AndrewBCN/STM32-GPSDO/docs/pictures/CTI_datasheet1.jpg

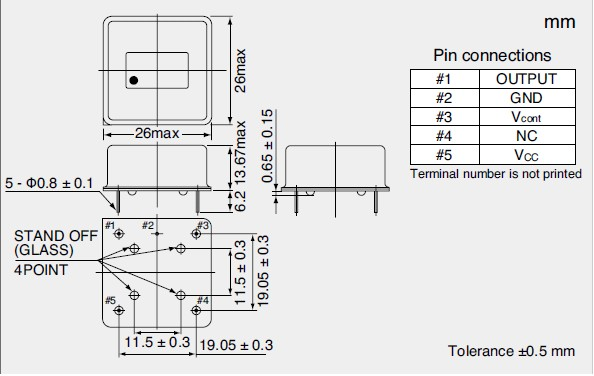
docs/pictures/CTI_datasheet1.jpg
