AndrewBCN/STM32-GPSDO/docs/pictures/CTI_OCXO_bottom.jpg

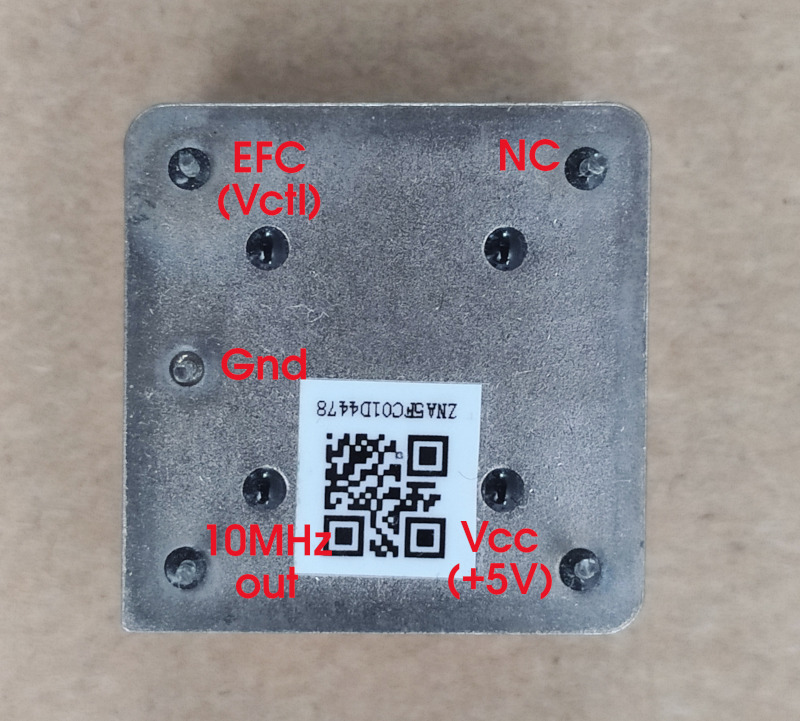
docs/pictures/CTI_OCXO_bottom.jpg
