AndrewBCN/STM32-GPSDO/docs/pictures/CTI_OCXO_top.jpg

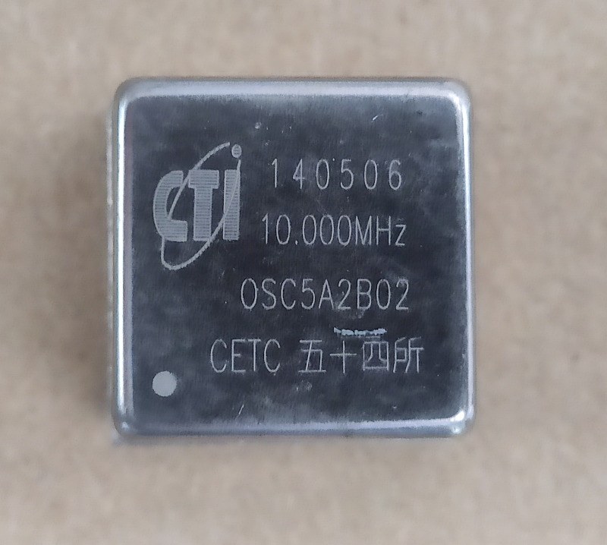
docs/pictures/CTI_OCXO_top.jpg
