AndrewBCN/STM32-GPSDO/docs/pictures/ocxo_datasheet2.png

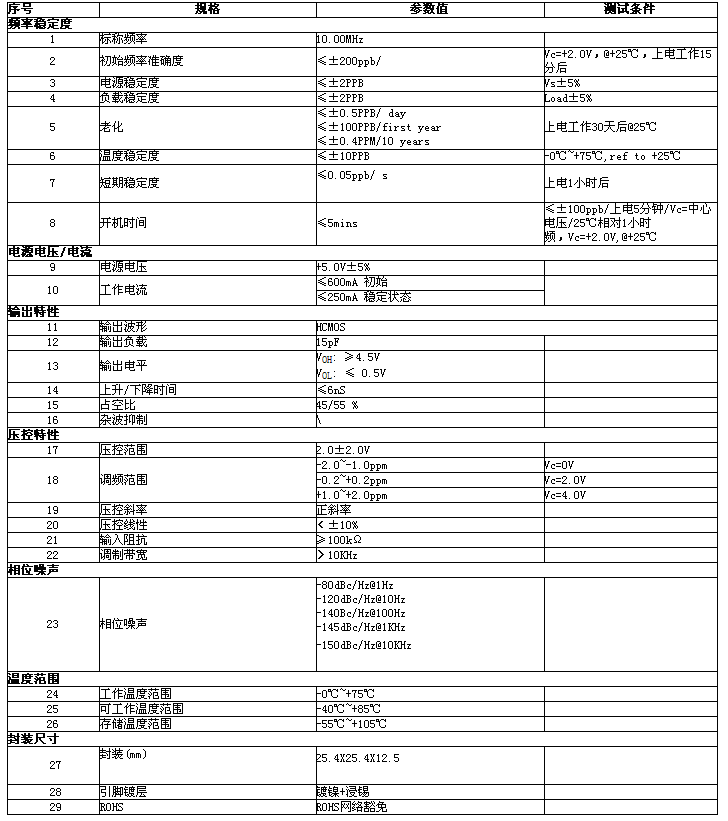
docs/pictures/ocxo_datasheet2.png
