AndrewBCN/STM32-GPSDO/(threads)

Thread 3 (2022-01-03):

STM32_CORE_VERSION error

dungar43, 2022-01-03:
I am new to this. After researching the error below I do'nt know what to do about it.
#error "Due to API change, this sketch is compatible with STM32_CORE_VERSION  >= 0x02000000"
I am compiling your code on the Arduino IDE 1.8.19 on a clone Blackpill. Libraries all work except for this error.

AndrewBCN, 2022-01-04:
This error during compilation means **you should update** the STM32 Arduino Core to a version 2.0.0 or later. The latest version is 2.2.0 and you can find it here: https://github.com/stm32duino/Arduino_Core_STM32.
This is very easy to do and takes just a couple of minutes. You are probably using one of the older versions (1.9.0 or earlier) which have bugs that prevent proper compilation of the STM32 GPSDO code.

dungar43, 2022-01-27:
Thanks for the prompt reply. I'm getting back to this now and I can compile
and load the code on to the F411 but I can't get past the GPS
initialization.  Looks like you use Serial1
for GPS communication but I can't see what IO pins are assigned to Serial1.
I'm loading the code using a UART on pins A9,10.  I find how to use serial
ports on the  STM32 series to be confusing. Any ideas will be  appreciated.

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

felixd, 2022-01-28:
Hi, If I can jump into this thread.

@dungar43 **A9 and A10** pins are used for UART communication with GPS.

You can find Andrews **Schematics** here
https://www.eevblog.com/forum/projects/yet-another-diy-gpsdo-yes-another-one/msg3821813/#msg3821813

dungar43, 2022-01-28:
Great that's a big help. Thanks

On Fri, Jan 28, 2022 at 1:40 AM Paweł Wojciechowski <
***@***.***> wrote:

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

Closed 2022-01-04.

Thread 7 (2022-02-07):

Circuit diagram request

instantcrow, 2022-02-07:
Love the project. Building it on a different STM32. Trying to decipher a circuit diagram from the code using different pins. Probably won't be using the optional sensors. Should you have a circuit diagram, might you kindly post it? Thanks. Using this for homebrew radio projects.

AndrewBCN, 2022-02-07:
Thank you. The circuit diagram is available on the EEVBlog forum, in this thread: https://www.eevblog.com/forum/projects/yet-another-diy-gpsdo-yes-another-one/
And in that thread you can find a lot more information on this project.

Closed 2022-02-07.

Thread 12 (2023-01-05):

USB can't print debug log

skylin008, 2023-01-05:
Thank you shared this impressive project. I had finished  the new schematic and PCB from your schematic. Attatch the schematic and PCB( kicad ), but when plug the usb, it can't found the new device from Device management(Win 10),How to solove this issue. Thanks!
[GPSDO_V10.pdf](https://github.com/AndrewBCN/STM32-GPSDO/files/10349483/GPSDO_V10.pdf)

skylin008, 2023-01-05:
Attatch the pcb file(Kicad)
[Precision_GPSDO_PCB.zip](https://github.com/AndrewBCN/STM32-GPSDO/files/10350066/Precision_GPSDO_PCB.zip)

skylin008, 2023-01-05:
I used the platformIO

ZsZs73, 2024-11-12:
I know that you openned this issue long ago, but on the Weact Blackpill schematics there are 10k resistors between PA11/PA12 and the USB connector. Is there any reason why you've left them out?
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
