AndrewBCN/STM32-GPSDO/schematics/GPSDO-KiCad.pdf

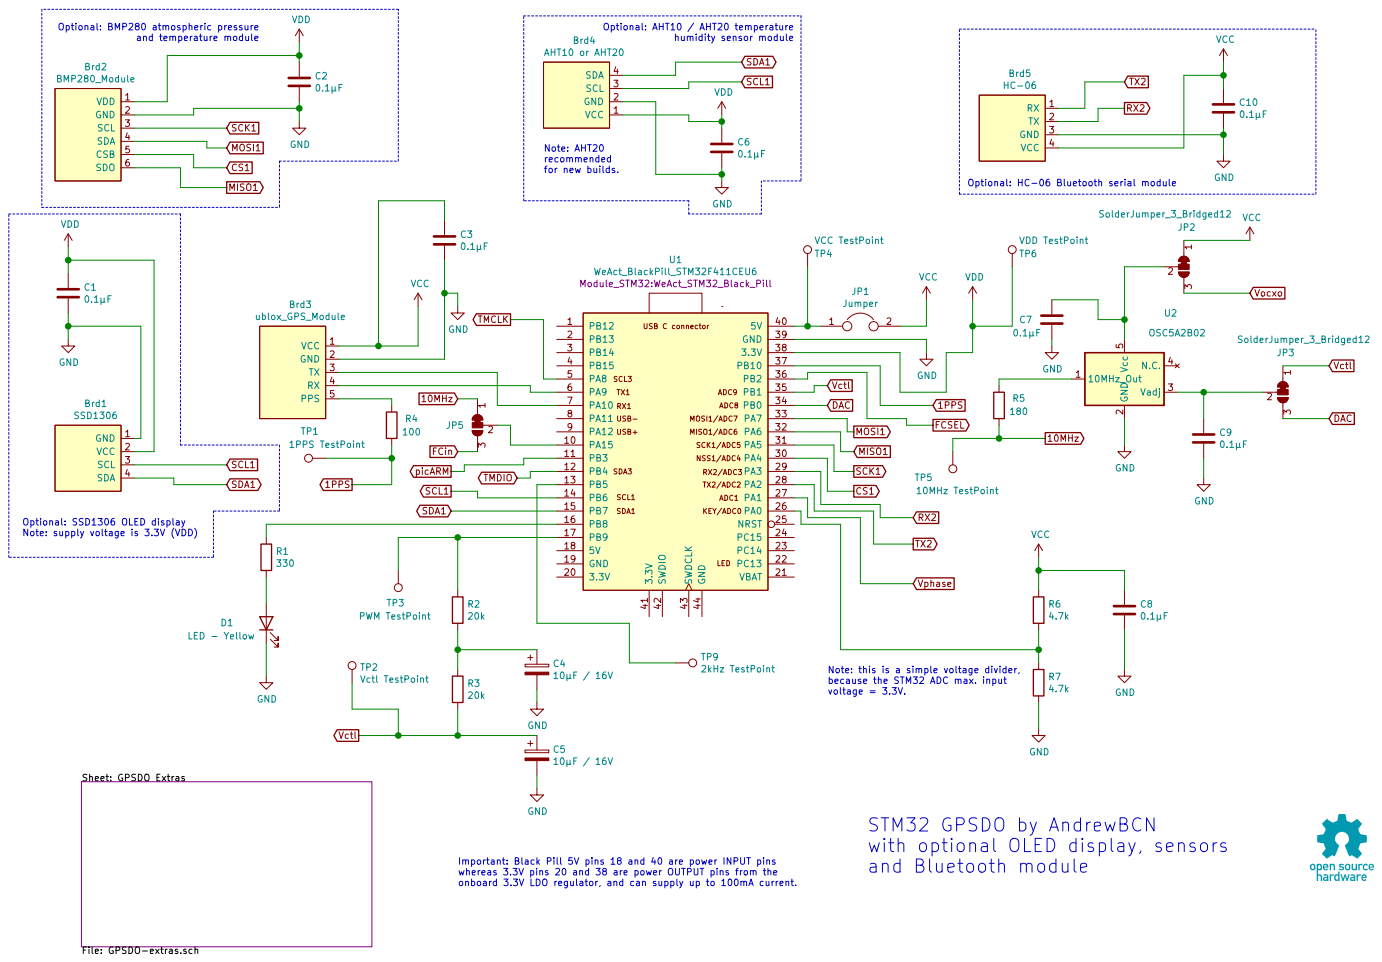
[picture p7: page 1]

Optional: BMP280 atmospheric pressure

Optional: AHT10 / AHT20 temperature

Optional: HC-06 Bluetooth serial module

Optional: SSD1306 OLED display
Note: supply voltage is 3.3V (VDD)

Note: this is a simple voltage divider,
because the STM32 ADC max. input
voltage = 3.3V.

with optional OLED display, sensors
and Bluetooth module

Important: Black Pill 5V pins 18 and 40 are power INPUT pins
whereas 3.3V pins 20 and 38 are power OUTPUT pins from the
onboard 3.3V LDO regulator, and can supply up to 100mA current.

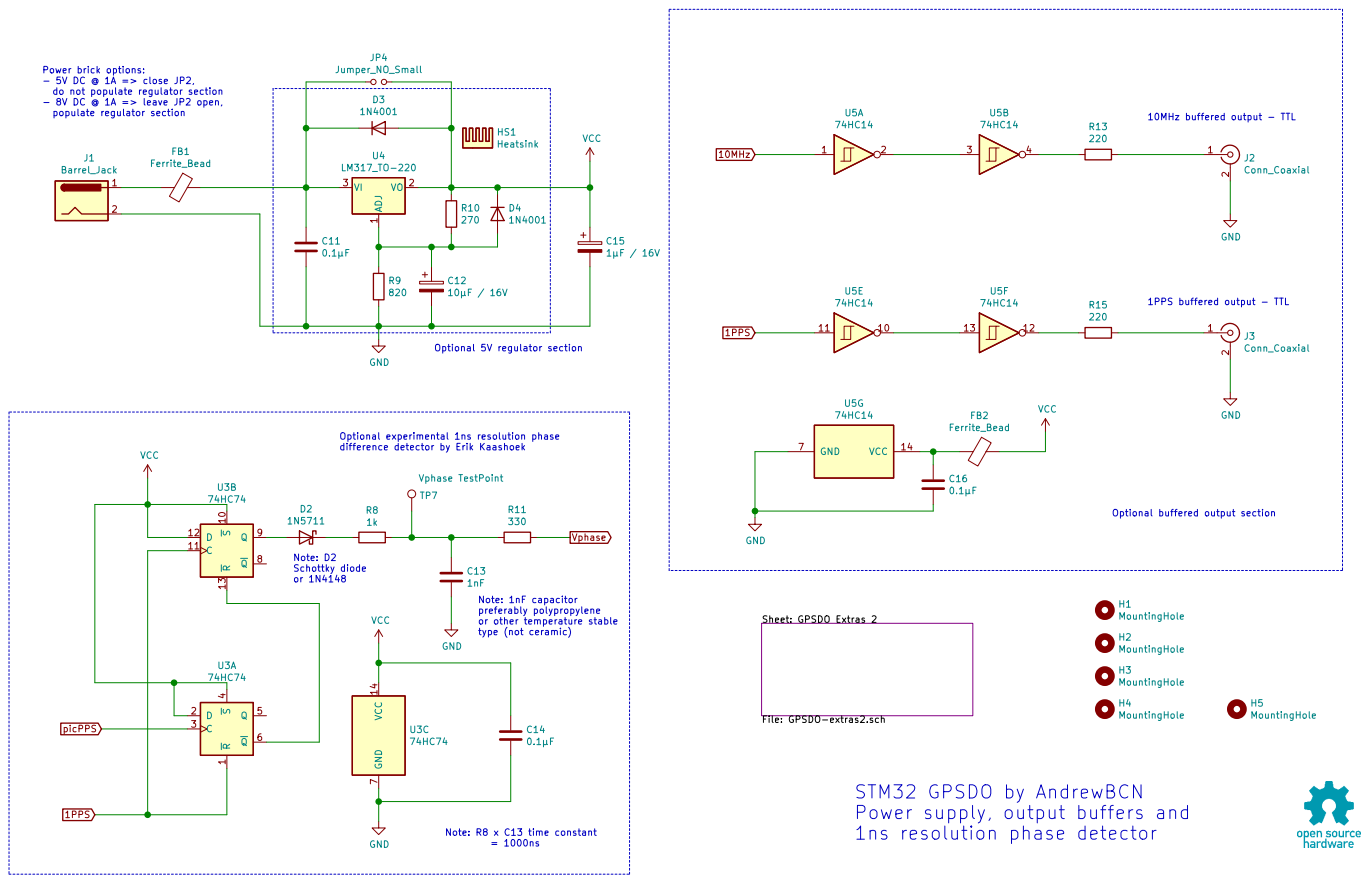
[picture p8: page 2]

Power brick options:
- 5V DC @ 1A => close JP2,
do not populate regulator section
- 8V DC @ 1A => leave JP2 open,
populate regulator section

or 1N4148 Optional experimental 1ns resolution phase

difference detector by Erik Kaashoek Note: R8 x C13 time constant

Sheet: GPSDO Extras 2 File: GPSDO-extras2.sch VCC

Optional buffered output section

type (not ceramic) Note: D2 Schottky diode

Note: 1nF capacitor
preferably polypropylene
or other temperature stable

Power supply, output buffers and
1ns resolution phase detector

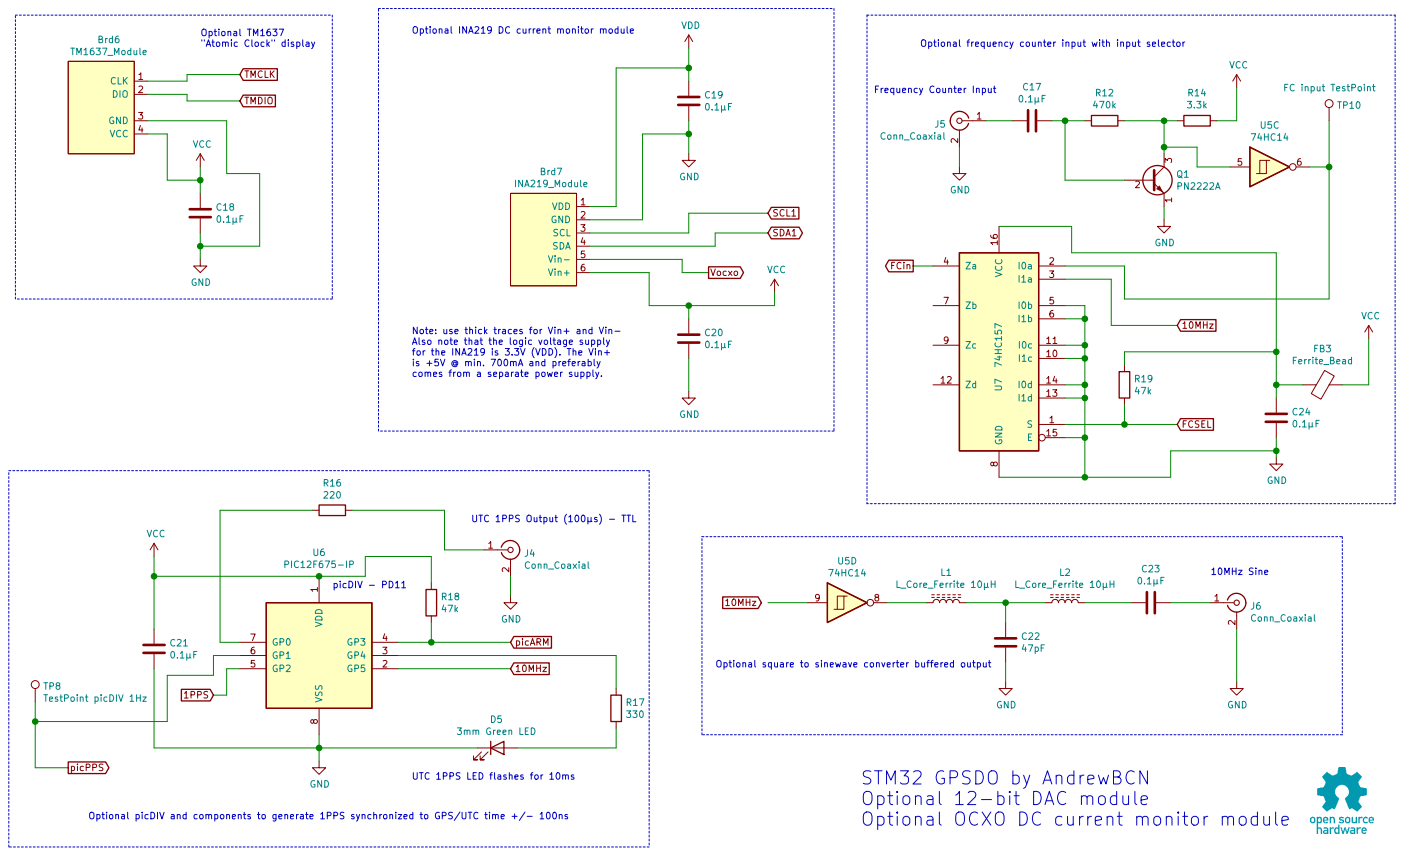
[picture p9: page 3]

Optional INA219 DC current monitor module

Optional frequency counter input with input selector

0.1µF GND GND
comes from a separate power supply. UTC 1PPS LED flashes for 10ms

10MHz Note: use thick traces for Vin+ and Vin- Also note that the logic voltage supply

for the INA219 is 3.3V (VDD). The Vin+
is +5V @ min. 700mA and preferably

STM32 GPSDO by AndrewBCN
Optional 12-bit DAC module
Optional OCXO DC current monitor module
