AndrewBCN/STM32-GPSDO/software/GPSDO_V006c/GPSDO_V006c.ino

/**********************************************************************************************************
  STM32 GPSDO v0.06c by André Balsa, May 2022
  GPLV3 license
  GitHub collaborators: iannezsp (Angelo Iannello)
  ST7735 SPI LCD display support code (experimental) contributed by Badwater-Frank

  This program is supplied as is, it is up to the user of the program to decide if the program is
  suitable for the intended purpose and free from errors.
**********************************************************************************************************
  When the program detects that the GPS has a fix, it prints status information to the USB serial
  or the Bluetooth serial (if the Bluetooth serial port is defined in the preprocessor directives).
  If the I2C OLED display is attached that is updated as well.

  The USB serial port is set at 115200 baud, the Bluetooth serial port at 57600 baud, and the GPS
  serial port is set initially at 9600 baud then reconfigured at 38400 baud.
**********************************************************************************************************/
/* Libraries required to compile, depending on configured options:
    - TinyGPS++
    - U8g2/u8x8 graphics library, see https://github.com/olikraus/u8g2
    - Adafruit AHTX0
    - Adafruit BMP280
    - Adafruit INA219
    - movingAvg library, see https://github.com/JChristensen/movingAvg
    - Color LCD support requires the installation of the Adafruit ST7735 and ST7789 LCD library
      and the Adafruit GFX library. Note one must use a patched version of the Adafruit GFX library,
      available here: https://github.com/fpistm/Adafruit-GFX-Library/tree/Fix_pin_type
    - TM1637 LED clock module requires the TM1637 library, see https://github.com/avishorp/TM1637
    - For the PID controller(s): the Arduino PID library by Brett Beauregard, see https://github.com/br3ttb/Arduino-PID-Library
    - For the NN MLP controller: the NeuralNetwork library by George Chousos, see https://github.com/GiorgosXou/NeuralNetworks

   For commands parsing, uses SerialCommands library found here:
   https://github.com/ppedro74/Arduino-SerialCommands

   And also requires the installation of support for the STM32 MCUs by installing the STM32duino
   package (STM32 Core version 2.2.0 or later).
**********************************************************************************************************/
/* Commands implemented:
    - V : returns program name, version and author
    - H : list all the commands and their parameters if any
    - F : flush ring buffers
    - C : calibrate OCXO
    - dp/up 1/10 : adjust Vctl down/up PWM fine/coarse, example dp1 means decrease PWM by 1
    - SP <number> : set PWM to value between 1 and 65535
    - RD/RH : toggle between tab Delimited and Human readable GPSDO status reporting
    - ES/ER/EE : EEPROM Save, EEPROM Recall, EEPROM Erase
    - MH/MD : Mode Holdover (OCXO is not "disciplined" by GPS), Mode Disciplined
    - PO <float value> : Pressure Offset - calibrate atmospheric pressure and altitude sensor
    - AO <float value> : Altitude Offset - calibrate atmospheric pressure and altitude sensor
    - AP : arm and sync picDIV
    - TO <number>: set UTC to local time offset, between -23 and 23 (only for TM1637 clock display)
    - LA <0-9>: switches to Loop Algorithm 0 to 9.
    
/* Commands to be implemented:
    - S0 to S9 : select log levels ; these only take effect in Human Readable reporting mode
    - S0 : silence mode - no output at all
    - S1 : one stop . every second, newline \n every minute
    - S2 : fix only mode
    - S7 : fix and full status mode, no NMEA (default)
    - S8 : NMEA stream from GPS module only mode
    - S9 : NMEA + full status

/**********************************************************************************************************
  Program Operation -  This program is a GPSDO with optional OLED display. It uses a small SSD1306
  128x64 I2C OLED display. At startup the program starts checking the data coming from the GPS for a
  valid fix. It reads the GPS NMEA stream for 1/5 seconds and if there is no fix, prints a message on the
  Arduino IDE serial monitor and updates the seconds without a fix on the display. During this time the
  NMEA stream coming from the GPS is copied to the serial monitor also. The DFLL is active as soon as
  the GPS starts providing a 1PPS pulse. The 10MHz OCXO is controlled by a voltage generated by either
  the 16-bit PWM ; this voltage (Vctl) is adjusted once every 429 seconds.
**********************************************************************************************************/

/**********************************************************************************************************
 * A quick note about calibrating the BMP pressure / altitude sensor in two simple steps:
 * 1. Get the atmospheric pressure in hPa from the nearest weather station. Then use the PO command to
 *    adjust the reported value from the BMP280 until it matches that from the weather station.
 * 2. Get the altitude for your location from Google Maps or similar service (or the GPS value). Then use
 *    the AO command to adjust the reported value from the BMP280 until it matches that from Google Maps.
**********************************************************************************************************/

// Version v0.05j and later: reporting on USB serial / Bluetooth serial can be toggled between human readable and tab delimited data.

// Version v0.05k and later: EEPROM emulation in Flash allows for saving a 16-bit PWM DAC value (and in the future,
// other operating parameters). Note that saving the values in EEPROM causes the ring buffer to get flushed.

// Version v0.06c:
//  - The frequency measurement algorithm now uses 8-bit information about frequency offset in a single unified
//    ring buffer rather than 64-bit counter data in multiple separate ring buffers. For the 10,000s data set,
//    this saves 70kB of RAM, and allows using the STM32F401CCU6 Black Pill variant without any firmware changes.
//  - Holdover Mode / Disciplined Mode commands implemented
//    Note that in Holdover Mode the PWM DAC value can still be set manually using the SP command
//  - Pressure Offset (PO) and Altitude Offset (AO) commands implemented
//  - picDIV synchronization control and AP (arm picDIV) command
//  - Reading TIC measuring phase difference between GPS PPS and picDIV PPS and discharge capacitor
//  - STM32F401CCU6 Black Pill (lower cost version with less RAM and flash) now fully supported
//  - TM1637 clock module can show UTC or local time. Local time to UTC time offset can be configured using TO command.
//  - Control loop algorithms in separate file and LA (Loop Algorithm) command to choose active control loop algorithm.

// TODO
// 1. Refactor the entire program to make it easier to understand and maintain.
// 2. Frequency / period meter implementation.
// 3. Improve layout and refresh speed of ST7789 display.
// 4. Implement hybrid PLL/FLL control loop algorithm and < 100ns UTC PPS sync.
// 5. Implement very long period frequency data collection with 10s sampling.
// 6. Investigate weighed/exponential averaging.
// 7. Program control loop algorithms as C++ objects rather than functions.

#define Program_Name "GPSDO"
#define Program_Version "v0.06c"
#define Author_Name "André Balsa"
#define Contributors "Angelo Iannelli"

// Debug options
// -------------
#define FastBootMode          // reduce various delays during boot
#define TunnelModeTesting     // reduce tunnel mode timeout

// Control loop algorithms options
// -------------------------------
#include "GPSDO_algorithms.h"
const uint8_t default_cla = 0;   // default (startup) control loop algorithm
uint8_t active_cla = 0;          // active control loop algorithm, can be changed using LA command
const uint8_t maxalgonumber = 9; // maximum number of control loop algorithms, not counting algorithm 0

// Hardware options
// ----------------
// #define GPSDO_STM32F401       // use an STM32F401 Black Pill instead of STM32F411 (reduced RAM)
                                 // IMPORTANT! Don't forget to select the correct board in the "Tools"->"Board Part Number" menu in the Arduino IDE
#define GPSDO_OLED            // SSD1306 128x64 I2C OLED display
// #define GPSDO_LCD_ST7735      // ST7735 160x128 SPI LCD display
// #define GPSDO_LCD_ST7789      // ST7789 240x240 SPI LCD display (testing)
#define GPSDO_PWM_DAC         // STM32 16-bit PWM DAC, requires two rc filters (2xr=20k, 2xc=10uF) - always enable this!
#define GPSDO_AHT10           // AHT10 or AHT20 (recommended) I2C temperature and humidity sensor
#define GPSDO_GEN_2kHz_PB5    // generate 2kHz square wave test signal on pin PB5 using Timer 3
// #define GPSDO_BMP280_SPI      // SPI atmospheric pressure, temperature and altitude sensor
#define GPSDO_BMP280_I2C      // I2C atmospheric pressure, temperature and altitude sensor
#define GPSDO_INA219          // INA219 I2C current and voltage sensor
// #define GPSDO_BLUETOOTH       // Bluetooth serial (HC-06 module)
#define GPSDO_VCC             // Vcc (nominal 5V) ; reading Vcc requires two resistors 1:2 voltage divider to PA0
#define GPSDO_VDD             // Vdd (nominal 3.3V) reads VREF internal ADC channel
#define GPSDO_UBX_CONFIG      // optimize u-blox GPS receiver configuration
#define GPSDO_VERBOSE_NMEA    // GPS module NMEA stream echoed to USB serial xor Bluetooth serial
#define GPSDO_PICDIV          // generate a (longer than) 1.2s arming pulse for the picDIV
#define GPSDO_TM1637          // TM1637 4-digit clock LED module
#define GPSDO_LTIC            // read Lars' TIC Vphase 12-bit value on PA1 (ADC channel 1), then discharge TIC capacitor
#define GPSDO_EEPROM          // enable STM32 buffered EEPROM emulation library

// Includes
// --------
#if !defined(STM32_CORE_VERSION) || (STM32_CORE_VERSION  < 0x02020000)
  #error "Due to API changes, this sketch is compatible with STM32_CORE_VERSION >= 0x02020000 (2.2.0 or later)"
#endif

// Increase HardwareSerial (UART) TX and RX buffer sizes from default 64 characters to 256.
// The main worry here is that we could miss some characters from the u-blox GPS module if
// the processor is busy doing something else (e.g. updating the display, reading a sensor, etc)
// specially since we increase the GPS baud rate from 9600 to 38400.

#define SERIAL_TX_BUFFER_SIZE 256       // Warning: > 256 could cause problems, see comments in STM32 HardwareSerial library
#define SERIAL_RX_BUFFER_SIZE 256

bool report_tab_delimited = false;      // true for tab delimited reporting, false for human-readable reporting
uint64_t report_line_no = 0;            // line number for tab delimited reporting, 0 if no GPS fix

const uint16_t waitFixTime = 1;         // Maximum time in seconds waiting for a fix before reporting no fix / yes fix
                                        // Tested values 1 second and 5 seconds, 1s recommended

#include <movingAvg.h>                  // https://github.com/JChristensen/movingAvg

// picDIV support
#ifdef GPSDO_PICDIV
  #define picDIVarmPin PB3               // digital output pin used to generate a 1.1s arming (low) pulse for the picDIV
  #define picdivArmDelay 1001            // low pulse width = time in ms required to arm picDIV, 1001ms
  bool must_arm_picDIV = false;          // indicates picDIV must be armed waiting to sync on next PPS from GPS module
  uint64_t arming_started = 0;           // millis() value when the picDIV was armed
#endif // PICDIV

#ifdef GPSDO_LTIC
  #define VphaseInputPin PA1              // ADC pin to read Vphase from Lars' TIC, also used to discharge 1nF capacitor
  #define DischargeTime 1                 // time in ms required to discharge 1nF capacitor - in principle with 330R resistor, 1 ms is more than enough time
  volatile bool must_read_Vphase = false; // flag indicating PPS has occurred (set by Timer2_Capture_ISR, cleared when we read Vphase)
  int adcVphase = 0;                      // 12-bit ADC value reading VPhaseInputPin
#endif // LTIC  

#ifdef GPSDO_GEN_2kHz_PB5
  #define Test2kHzOutputPin PB5           // digital output pin used to output a test 2kHz square wave
#endif // GEN_2kHz_PB5

// HC-06 Bluetooth module
#ifdef GPSDO_BLUETOOTH
  //              UART    RX   TX
  HardwareSerial Serial2(PA3, PA2);                // Serial connection to HC-06 Bluetooth module
  #define BT_BAUD 57600                            // Bluetooth baud rate
#endif // BLUETOOTH

// EEPROM emulation in flash - note this allocates flash_page_size bytes in RAM for buffer (16kB on STM32F411CEU6)
#ifdef GPSDO_EEPROM
  #include <EEPROM.h>                              // Buffered EEPROM emulation library
  char signature[6] = "GPSDO";
  bool sigalreadywritten = false;                  // checked every power on, if true, means we have previously saved the PWM DAC value
  uint16_t eeprom_page_size = 1024;                // actually 16k for STM32F411CEU6, but we are not going to use all that
#endif // EEPROM

#include <SerialCommands.h>                        // Commands parser library
char serial_command_buffer_[32];                   // buffer for commands library
// The following line determines which serial port we'll listen to
// "\n" means only newline needed to accept command
#ifdef GPSDO_BLUETOOTH
  SerialCommands serial_commands_(&Serial2, serial_command_buffer_, sizeof(serial_command_buffer_), "\n", " ");
#else
  SerialCommands serial_commands_(&Serial, serial_command_buffer_, sizeof(serial_command_buffer_), "\n", " ");
#endif // BLUETOOTH

#include <TinyGPS++.h>                             // get library here > http://arduiniana.org/libraries/tinygpsplus/
TinyGPSPlus gps;                                   // create the TinyGPS++ object

#include <Wire.h>                                  // Hardware I2C library on STM32

// AHT10 / AHT20 temperature humidity sensor       // Uses PB6 (SCL1) and PB7 (SDA1) on Black Pill for I2C1
#ifdef GPSDO_AHT10
  #include <Adafruit_AHTX0.h>                      // Adafruit AHTX0 library
  Adafruit_AHTX0 aht;                              // create object aht
#endif // AHT10

// INA219 current voltage sensor
#ifdef GPSDO_INA219
  #include <Adafruit_INA219.h>
  Adafruit_INA219 ina219;
  float ina219volt=0.0, ina219curr=0.0;
#endif // INA219

// TM1637 4-digit LED module
#ifdef GPSDO_TM1637
  #include <TM1637Display.h>                      // get library here > https://github.com/avishorp/TM1637
  bool showlocaltime = true;                      // show local time if true, UTC time if false
  int8_t timeoffset = 2;                          // UTC to local time offset, only used for TM1637 clock!
  // Module connection pins (Digital Pins)
  #define CLK PA8                                 // interface to TM1637 requires two GPIO pins
  #define DIO PB4
  TM1637Display tm1637(CLK, DIO);                 // create tm1637 object
  const uint8_t mid_dashes[] = {
    SEG_G,   // -
    SEG_G,   // -
    SEG_G,   // -
    SEG_G    // -
  };
  const uint8_t low_oooo_s[] = {
    SEG_C | SEG_D | SEG_E | SEG_G,   // o
    SEG_C | SEG_D | SEG_E | SEG_G,   // o
    SEG_C | SEG_D | SEG_E | SEG_G,   // o
    SEG_C | SEG_D | SEG_E | SEG_G    // o
  };
#endif // TM1637

// OLED 0.96 SSD1306 128x64
#ifdef GPSDO_OLED
  #include <U8x8lib.h>                                      // get library here >  https://github.com/olikraus/u8g2 
  U8X8_SSD1306_128X64_NONAME_HW_I2C disp(U8X8_PIN_NONE);    // use this line for standard 0.96" SSD1306
#endif // OLED

// LCD 1.8" ST7735 160x128 (tested by Badwater-Frank and Nealix)
#ifdef GPSDO_LCD_ST7735
/**********************************************************************************************************
  IMPORTANT ST7735 1.8" LCD NOTES:
  nealix tested this display successfully by using the following pins:
  LCD Pins     STM32 Black Pill Pins
  --------     ---------------------
  1 GND        Ground
  2 VCC        WARNING! Some ST7735 LCD modules VCC are 3.3 Volts ONLY, not 3.3V + 5V tolerant
  3 SCL        Pin PA5     (STM32 SCLK-1)
  4 SDA        Pin PA7     (STM32 MOSI-1)
  5 RES        Pin PB15    (We define it below)
  6 D/C        Pin PB12    (We define it below)
  7 CS         Pin PB13    (We define it below)
**********************************************************************************************************/
  #include <Adafruit_GFX.h> // MUST USE THIS VERSION!! for STM32F4xx/F411C: https://github.com/fpistm/Adafruit-GFX-Library/tree/Fix_pin_type
  #include <Adafruit_ST7735.h>
  #include <SPI.h>
  #define TFT_DC  PB12             // these pins do not conflict with any other STM32F411 functionality
  #define TFT_CS  PB13
  #define TFT_RST PB15
  // For 1.44" and 1.8" TFT with ST7735 use:
  Adafruit_ST7735 disp = Adafruit_ST7735(TFT_CS, TFT_DC, TFT_RST);
  // Below array is for printing month name on the ST7735 LCD display, using the existing integer month value as an index.
  #define ARRAYSIZE 13  // index starts from 0, but 12 month names (index 1 to index 12) after that.
  String MonthText[ARRAYSIZE] = {" ", "JAN", "FEB", "MAR", "APR", "MAY", "JUN", "JUL", "AUG", "SEP", "OCT", "NOV", "DEC"};
#endif // LCD_ST7735

// LCD 1.3" ST7789 240x240 (Testing)
#ifdef GPSDO_LCD_ST7789
  #include <Adafruit_GFX.h>       // need this adapted for STM32F4xx/F411C: https://github.com/fpistm/Adafruit-GFX-Library/tree/Fix_pin_type
  #include <Adafruit_ST7789.h>
  #include <SPI.h>
  #define TFT_DC  PB12            // note pin assigment that does not conflict with other interfaces
  #define TFT_CS  PB13            // in reality, CS not connected, CS not used on 1.3" TFT ST7789 display
  #define TFT_RST PB15            // also uses pins PA5, PA6, PA7 for MOSI MISO and SCLK
  // For 1.3" LCD with ST7789
  Adafruit_ST7789 disp_st7789 = Adafruit_ST7789(TFT_CS, TFT_DC, TFT_RST);
  bool must_clear_disp_st7789 = false;  // flag is set when display has to be cleared 
  
  // include the following GFX library fonts
  #include <Fonts/FreeMono9pt7b.h>      // tiny, but readable in white
  #include <Fonts/FreeMonoBold12pt7b.h> // medium size, readable
#endif // LCD_ST7789

// PWM 16-bit DAC
const uint16_t default_PWM_output = 35585; // "ideal" 16-bit PWM value, varies with OCXO, RC network, and time and temperature
                                           // 35585 for a second NDK ENE3311B
uint16_t adjusted_PWM_output;              // we adjust this value to "close the loop" of the DFLL when using the PWM
volatile bool must_adjust_DAC = false;     // true when there is enough data to adjust Vctl
char trendstr[5] = " ___";            // PWM trend string, set in the adjustVctlPWM() function

#define VctlPWMOutputPin PB9          // digital output pin used to output a PWM value, TIM4 ch4
                                      // Two cascaded RC filters transform the PWM into an analog DC value
#define VctlPWMInputPin PB1           // ADC pin to read Vctl from filtered PWM
volatile int pwmVctl = 0;             // variable used to store PWM Vctl read by ADC pin PB1

// VCC - 5V
#ifdef GPSDO_VCC
  #define VccDiv2InputPin PA0           // Vcc/2 using resistor divider connects to PA0
  int adcVcc = 0;
#endif // VCC

// VDD - 3.3V
#ifdef GPSDO_VDD
  int adcVdd = 0;                      // Vdd is read internally as Vref
#endif // VDD

// movingAvg objects for the voltages measured by MCU ADC
// all averages over 10 samples (10 seconds in principle)
#ifdef GPSDO_LTIC
  movingAvg avg_adcVphase(10);
  int16_t avgVphase = 0;
#endif // LTIC

#ifdef GPSDO_VDD
  movingAvg avg_adcVdd(10);
  int16_t avgVdd = 0;
#endif // VDD

#ifdef GPSDO_VCC
  movingAvg avg_adcVcc(10);
  int16_t avgVcc = 0;
#endif // VCC

movingAvg avg_pwmVctl(10);
int16_t avgpwmVctl = 0;

// BMP280 atmospheric pressure and temperature sensor
#ifdef GPSDO_BMP280_SPI
  // BMP280 - SPI
  #include <SPI.h>
  #include <Adafruit_BMP280.h>
  #define BMP280_CS   (PA4)              // SPI1 uses PA4, PA5, PA6, PA7
  Adafruit_BMP280 bmp(BMP280_CS);        // hardware SPI, use PA4 as Chip Select
#endif // BMP280_SPI

#ifdef GPSDO_BMP280_I2C
  // BMP280 - I2C
  #include <Adafruit_BMP280.h>
  Adafruit_BMP280 bmp;                  // hardware I2C
#endif // BMP280_I2C

#if (defined (GPSDO_BMP280_SPI) || defined (GPSDO_BMP280_I2C))
  float PressureOffset = 1230.0;  // that offset must be calculated for your sensor and local atmospheric pressure
  float AltitudeOffset = 1.0;     // that offset must be calculates for your sensor and local altitude
  float bmp280temp=0.0, bmp280pres=0.0, bmp280alti=0.0; // read sensor, save values here
#endif // BMP280

// LEDs
// Blue onboard LED blinks to indicate ISR is working
#define blueledpin  PC13    // Blue onboard LED is on PC13 on STM32F411CEU6 Black Pill
// Yellow extra LED is off, on or blinking to indicate some GPSDO status
#define yellowledpin PB8   // Yellow LED on PB8
volatile int yellow_led_state = 2;  // global variable 0=off 1=on 2=1Hz blink

// GPS data
float GPSLat;                                      // Latitude from GPS
float GPSLon;                                      // Longitude from GPS
float GPSAlt;                                      // Altitude from GPS
uint8_t GPSSats;                                   // number of GPS satellites in use
uint32_t GPSHdop;                                  // HDOP from GPS
uint8_t hours, mins, secs, day, month;
uint16_t year;
uint32_t startGetFixmS;
uint32_t endFixmS;

// Uptime data
volatile uint8_t  uphours = 0;
volatile uint8_t  upminutes = 0;
volatile uint8_t  upseconds = 0;
volatile uint16_t updays = 0;
volatile bool halfsecond = false;
char uptimestr[9] = "00:00:00";    // uptime string
char updaysstr[5] = "000d";        // updays string

// OCXO frequency measurement
// Uses 8-bit frequency offset data instead of 64-bit counter values
// Uses a single "unified" circular buffer holding 20000 seconds of 1-byte offsets, so uses 20000 bytes of RAM

volatile int8_t instant_offset = 0;   // last measured frequency offset from 10MHz (measured frequency - 10^7)
volatile int8_t circbuf_offset[20000]; // 20000 seconds unified circular buffer for offsets - note the index range is 0-19999      
volatile int16_t cumulten_offset = 0; // cumulative offset over the last 10 seconds (used to calculate frequency average over last 10 seconds)
volatile int16_t cumulhun_offset = 0; // cumulative offset over the last 100 seconds (used to calculate frequency average over last 100 seconds)
volatile int16_t cumultho_offset = 0; // cumulative offset over the last 1000 seconds (used to calculate frequency average over last 1000 seconds)
volatile int16_t cumultth_offset = 0; // cumulative offset over the last 10000 seconds (used to calculate frequency average over last 10000 seconds)
volatile int16_t cumul20k_offset = 0; // cumulative offset over the last 20000 seconds (used to calculate frequency average over last 20000 seconds)
volatile uint32_t coffset_newest = 0; // newest index for offset ring buffer, varies from 0 to 19999
volatile bool coten_full = false;     // flag set when buffer has filled up with 10s of data
volatile bool cohun_full = false;     // flag set when buffer has filled up with 100s of data
volatile bool cotho_full = false;     // flag set when buffer has filled up with 1000s of data
volatile bool cotth_full = false;     // flag set when buffer has filled up with 10000s of data
volatile bool co20k_full = false;     // flag set when buffer has filled up with 20000s of data
volatile double oavgften=0, oavgfhun=0, oavgftho=0, oavgftth=0, oavgf20k=0; // average frequency calculated from cumulative offset, for respective length of time                    

// other OCXO frequency measurement data structures
const uint32_t basefreq=10000000;        // OCXO nominal frequency in Hz
volatile uint32_t lsfcount=0, previousfcount=0, calcfreqint=basefreq;

// Frequency check boundaries 
const uint32_t lowerfcount = 9999500;
const uint32_t upperfcount = 10000500;

// Other frequency measurement variables
volatile uint64_t fcount64=0, prevfcount64=0, calcfreq64=basefreq; 
// ATTENTION! must declare 64-bit, not 32-bit variable, because of shift
volatile uint64_t tim2overflowcounter = 0;  // counts the number of times TIM2 overflows
volatile bool overflowflag = false;         // flag set by the overflow ISR, reset by the 2Hz ISR
volatile bool captureflag = false;          // flag set by the capture ISR, reset by the 2Hz ISR
volatile bool overflowErrorFlag = false;    // flag set if there was an overflow processing error

volatile bool flush_ring_buffers_flag = true;  // indicates ring buffer should be flushed

// Miscellaneous data structures

// PPS counter, increments once per PPS pulse, reset to zero when buffer is flushed
volatile uint32_t ppscount = 0;               // used by control loop algorithms to determine update periodicity

// holdover mode / disciplined mode switch
bool holdover_mode = false;                     // always start in disciplined mode

// calibration
volatile bool force_calibration_flag = true;   // indicates GPSDO should start calibration sequence

volatile bool ocxo_needs_warming = true;       // indicates OCXO needs to warm up a few minutes after power on

#ifdef FastBootMode
  const uint16_t ocxo_warmup_time = 15;        // ocxo warmup time in seconds; 15s for testing
  const uint16_t ocxo_calib_time = 15;         // 15s fast calibration countdown time (for each calibration step)
#else             
  const uint16_t ocxo_warmup_time = 300;       // ocxo warmup time in seconds;  300s or 600s normal use
  const uint16_t ocxo_calib_time = 60;         // 60s normal calibration countdown time (for each calibration step)
#endif  // FastBootMode

volatile bool tunnel_mode_flag = false;        // the GPSDO relays the information directly to and from the GPS module to the USB serial
#ifdef TunnelModeTesting
  const uint16_t tunnelSecs = 15;                // tunnel mode timeout in seconds; 15s for testing, 300s or 600s normal use
#else
  const uint16_t tunnelSecs = 300;               // tunnel mode timeout in seconds; 15s for testing, 300s or 600s normal use
#endif  // TunnelModeTesting

// Miscellaneous functions

// SerialCommands callback functions
// This is the default handler, and gets called when no other command matches. 
void cmd_unrecognized(SerialCommands* sender, const char* cmd)
{
  sender->GetSerial()->print(F("Unrecognized command <"));
  sender->GetSerial()->print(cmd);
  sender->GetSerial()->println(F(">"));
  sender->GetSerial()->println(F("Type <H> for list of valid commands"));
}

// called for V (version) command
void cmd_version(SerialCommands* sender)
{
  sender->GetSerial()->print(F(Program_Name));
  sender->GetSerial()->print(F(" - "));
  sender->GetSerial()->print(F(Program_Version));
  sender->GetSerial()->print(F(" by "));
  sender->GetSerial()->println(F(Author_Name));
}

#if (defined (GPSDO_BMP280_SPI) || defined (GPSDO_BMP280_I2C))
  // called for PO (Pressure Offset) command
  void cmd_pressoffset(SerialCommands* sender)
  {
    float po;
    char* po_str = sender->Next();
    if (po_str == NULL) { // if no value was specified, reports current value
      sender->GetSerial()->print(F("No Pressure Offset value specified, current value is "));
      sender->GetSerial()->println(PressureOffset, 2);
    }
    else // check the value that was specified
    {
      po = atof(po_str); // note atof() returns zero if it cannot convert the string to a valid integer
      if (((po >= 1) && (po <= 3000)) || ((po <= -1) && (po >= -3000))) // check if the value specified is not zero and reasonable
      {
        sender->GetSerial()->print(F("Setting Pressure Offset value ")); // if yes, set the value
        sender->GetSerial()->println(po, 2);
        PressureOffset = po;
      }
      else // incorrect value specified, print error message
      {
        sender->GetSerial()->println(F("Specified Pressure Offset invalid, leaving unchanged"));  
      }  
    }
  }
  
  // called for AO (Altitude Offset) command
  void cmd_altitoffset(SerialCommands* sender)
  {
    float ao;
    char* ao_str = sender->Next();
    if (ao_str == NULL) { // if no value was specified, reports current value
      sender->GetSerial()->print(F("No Altitude Offset value specified, current value is "));
      sender->GetSerial()->println(AltitudeOffset, 2);
    }
    else // check the value that was specified
    {
      ao = atof(ao_str); // note atoi() returns zero if it cannot convert the string to a valid integer
      if (((ao >= 1) && (ao <= 3000)) || ((ao <= -1) && (ao >= -3000))) // check if the value specified is not zero and reasonable
      {
        sender->GetSerial()->print(F("Setting Altitude Offset value ")); // if yes, set the value
        sender->GetSerial()->println(ao, 2);
        AltitudeOffset = ao;
      }
      else // incorrect value specified, print error message
      {
        sender->GetSerial()->println(F("Specified Altitude Offset invalid, leaving unchanged"));  
      }  
    }
  }
#endif // BMP280

#ifdef GPSDO_TM1637
  // called for TO (UTC to local Time Offset) command
  void cmd_lcltimeoffset(SerialCommands* sender)
  {
    int to;
    char* to_str = sender->Next();
    if (to_str == NULL) { // if no value was specified, reports current value
      sender->GetSerial()->print(F("No UTC to local Time Offset value specified, current value is "));
      sender->GetSerial()->println(timeoffset);
    }
    else // check the value that was specified
    {
      to = atoi(to_str); // note atoi() returns zero if it cannot convert the string to a valid integer
      if ((to <= 23) && (to >= -23))  // check if the value specified is within bounds
      {
        sender->GetSerial()->print(F("Setting UTC to local Time Offset value ")); // if yes, set the value
        sender->GetSerial()->println(to);
        timeoffset = to;
      }
      else // incorrect value specified, print error message
      {
        sender->GetSerial()->println(F("Specified UTC to local Time Offset invalid, leaving unchanged"));  
      }  
    }
  }
#endif // TM1637

// called for RD (Report tab Delimited format) command
void cmd_repdel(SerialCommands* sender)
{
  report_tab_delimited = true;  // set switch
  sender->GetSerial()->println(F("Switching to reporting in Tab Delimited Format"));
}

// called for RH (Report Human readable format) command
void cmd_rephum(SerialCommands* sender)
{
  report_tab_delimited = false;  // reset switch
  report_line_no = 0;            // reset line counter
  sender->GetSerial()->println(F("Switching to reporting in Human Readable Format"));
}

// called for MD (Mode Disciplined) command
void cmd_modedisc(SerialCommands* sender)
{
  holdover_mode = false;  // set operating mode disciplined
  sender->GetSerial()->println(F("Switching to Disciplined Mode"));
}

// called for MH (Mode Holdover) command
void cmd_modehold(SerialCommands* sender)
{
  holdover_mode = true;  // set operating mode holdover
  sender->GetSerial()->println(F("Switching to Holdover Mode"));
}

// called for F (flush ring buffers) command
void cmd_flush(SerialCommands* sender)
{
  flush_ring_buffers_flag = true;  // ring buffers will be flushed inside interrupt routine
  sender->GetSerial()->println(F("Ring buffers flushed"));
}

#ifdef GPSDO_PICDIV
  // called for AP (arm picDIV) command
  void cmd_armpicdiv(SerialCommands* sender)
  {
    must_arm_picDIV = true;  // request arming picDIV
    sender->GetSerial()->println(F("Arming picDIV, synchronization will take place at next PPS pulse from GPS receiver"));
  }
#endif // PICDIV

// called for C (calibration) command
void cmd_calibrate(SerialCommands* sender)
{
  force_calibration_flag = true;  // starts auto-calibration sequence
  sender->GetSerial()->println(F("Auto-calibration sequence started"));
}

// called for T (tunnel) command
void cmd_tunnel(SerialCommands* sender)
{
  tunnel_mode_flag = true;  // switches GPSDO operation to tunnel mode
  sender->GetSerial()->println(F("Switching to USB Serial <-> GPS tunnel mode"));
}

// called for SP (set PWM) command
void cmd_setPWM(SerialCommands* sender)
{
  int32_t pwm;
  char* pwm_str = sender->Next();
  if (pwm_str == NULL) // check if a value was specified
  {
    sender->GetSerial()->println(F("No PWM value specified, using default"));
    pwm = default_PWM_output;
    adjusted_PWM_output = pwm;
    analogWrite(VctlPWMOutputPin, adjusted_PWM_output);
  }
  else // check the value that was specified
  {
    pwm = atoi(pwm_str); // note atoi() returns zero if it cannot convert the string to a valid integer
    if ((pwm >= 1) && (pwm <= 65535)) // check if the value specified is positive 16-bit integer
    {
      sender->GetSerial()->print(F("Setting PWM value ")); // if yes, set the value
      sender->GetSerial()->println(pwm);
      adjusted_PWM_output = pwm;
      analogWrite(VctlPWMOutputPin, adjusted_PWM_output);
    }
    else // incorrect value specified, print error message
    {
      sender->GetSerial()->println(F("PWM value must be positive integer between 1 and 65535, leaving unchanged"));  
    }  
  }
}

// called for LA (Loop Algorithm) command
void cmd_setalgo(SerialCommands* sender)
{
  int to;
  char* to_str = sender->Next();
  if (to_str == NULL) { // if no value was specified, reports current value
    sender->GetSerial()->print(F("No Loop Algorithm specified, current algorithm is number "));
    sender->GetSerial()->println(active_cla);
  }
  else // check the value that was specified
  {
    to = atoi(to_str); // note atoi() returns zero if it cannot convert the string to a valid integer
    if ((to <= maxalgonumber) && (to >= 0))  // check if the value specified is within bounds
    {
      sender->GetSerial()->print(F("Setting Active Loop Algorithm to number ")); // if yes, set the value
      sender->GetSerial()->println(to);
      active_cla = to;
      // should we flush the ring buffer or not, after changing the control loop algorithm?
    }
    else // incorrect value specified, print error message
    {
      sender->GetSerial()->println(F("Specified Loop Algorithm number invalid, leaving unchanged"));  
    }  
  }
}

// PWM direct control commands (up/down)
// -------------------------------------
// called for up1 (increase PWM 1 bit) command
void cmd_up1(SerialCommands* sender)
{
  adjusted_PWM_output = adjusted_PWM_output + 1;
  analogWrite(VctlPWMOutputPin, adjusted_PWM_output);
  sender->GetSerial()->println(F("increased PWM 1 bit"));
}
// called for up10 (increase PWM 10 bits) command
void cmd_up10(SerialCommands* sender)
{
  adjusted_PWM_output = adjusted_PWM_output + 10;
  analogWrite(VctlPWMOutputPin, adjusted_PWM_output);
  sender->GetSerial()->println(F("increased PWM 10 bits"));
}
// called for dp1 (decrease PWM 1 bit) command
void cmd_dp1(SerialCommands* sender)
{
  adjusted_PWM_output = adjusted_PWM_output - 1;
  analogWrite(VctlPWMOutputPin, adjusted_PWM_output);
  sender->GetSerial()->println(F("decreased PWM 1 bit"));
}
// called for dp10 (decrease PWM 10 bits) command
void cmd_dp10(SerialCommands* sender)
{
  adjusted_PWM_output = adjusted_PWM_output - 10;
  analogWrite(VctlPWMOutputPin, adjusted_PWM_output);
  sender->GetSerial()->println(F("decreased PWM 10 bits"));
}

#ifdef GPSDO_EEPROM
// called for ES (EEPROM Save) command
void cmd_eepromsave(SerialCommands* sender)
{
  // write signature and PWM DAC value to EEPROM
  sender->GetSerial()->println(F("Please wait, saving PWM DAC value to EEPROM - ring buffer will be flushed"));
  // write signature, byte by byte
  for (uint16_t i = 0; i < 6; i++) {
      eeprom_buffered_write_byte(i, signature[i]);  // write signature to buffer
  }
  // write PWM DAC value to buffer
  eeprom_buffered_write_byte(6, highByte(adjusted_PWM_output)); // high byte to buffer
  eeprom_buffered_write_byte(7, lowByte(adjusted_PWM_output));  // low byte to buffer
  // Copy the data from the buffer to the flash
  eeprom_buffer_flush();  // note this is a long operation (up to 500ms)
  // now read back flash into buffer and check that writing was successful
  sigalreadywritten = true;
  // flush ring buffers
  flush_ring_buffers_flag = true;
}

// called for ER (EEPROM Recall) command
void cmd_eepromrecall(SerialCommands* sender)
{
  // first check that flash is really signed
  sigalreadywritten = true;
  eeprom_buffer_fill(); // fill the buffer with contents of Flash emulating EEPROM
  for (uint8_t csig = 0; csig < 6; csig++) {
    if (eeprom_buffered_read_byte(csig) != signature[csig]) sigalreadywritten = false;
  }
  // recall PWM DAC value from EEPROM
  if (sigalreadywritten) {
    sender->GetSerial()->println(F("Reading PWM DAC value from EEPROM"));
    adjusted_PWM_output = (256 * eeprom_buffered_read_byte(6)) + eeprom_buffered_read_byte(7);  // saved PWM value
    analogWrite(VctlPWMOutputPin, adjusted_PWM_output);
  }
  else sender->GetSerial()->println(F("EEPROM does not have valid signature, cannot read PWM DAC value"));
}

// called for EE (EEPROM Erase) command
void cmd_eepromerase(SerialCommands* sender)
{
  // erase EEPROM
  sender->GetSerial()->println(F("Please wait, erasing EEPROM - ring buffer will be flushed"));
  // Fill the buffer in memory with 0 to 255
  for (uint16_t i = 0; i < eeprom_page_size; i++) {
    eeprom_buffered_write_byte(i, i % 256);
  }
  // Copy the data from the buffer to the flash
  eeprom_buffer_flush();  // note this is a long operation (up to 500ms)
  sigalreadywritten = false;
  // flush ring buffers
  flush_ring_buffers_flag = true;
}
#endif // EEPROM

// called for H (Help) command
void cmd_help(SerialCommands* sender)
{
  sender->GetSerial()->print(F(Program_Name));
  sender->GetSerial()->print(F(" - "));
  sender->GetSerial()->print(F(Program_Version));
  sender->GetSerial()->print(F(" by "));
  sender->GetSerial()->println(F(Author_Name));
  sender->GetSerial()->println(F("Commands implemented:"));
  sender->GetSerial()->println(F("\t- V : returns program name, version and author"));
  sender->GetSerial()->println(F("\t- H : list all the commands and their parameters if any"));
  sender->GetSerial()->println(F("\t- F : flush ring buffers"));
  sender->GetSerial()->println(F("\t- C : calibrate OCXO"));
  sender->GetSerial()->println(F("\t- dp/up 1/10 : adjust Vctl down/up PWM fine/coarse, example dp1 means decrease PWM by 1"));
  sender->GetSerial()->println(F("\t- SP <number> : set PWM to value between 1 and 65535"));
  sender->GetSerial()->println(F("\t- RD/RH : toggle between tab Delimited and Human readable GPSDO status reporting"));
  sender->GetSerial()->println(F("\t- ES/ER/EE : EEPROM Save, EEPROM Recall, EEPROM Erase"));
  sender->GetSerial()->println(F("\t- MH/MD : Mode Holdover (OCXO is not \"disciplined\" by GPS), Mode Disciplined"));
  sender->GetSerial()->println(F("\t- PO <float value> : Pressure Offset - calibrate atmospheric pressure and altitude sensor"));
  sender->GetSerial()->println(F("\t- AO <float value> : Altitude Offset - calibrate atmospheric pressure and altitude sensor"));
  sender->GetSerial()->println(F("\t- AP : arm and sync picDIV"));
  sender->GetSerial()->println(F("\t- TO <number>: set UTC to local time offset, between -23 and 23 (only for TM1637 clock display)"));
  sender->GetSerial()->println(F("\t- LA <0-9>: switches to Loop Algorithm 0 to 9"));
  sender->GetSerial()->println(F("\t"));
}
    
// SerialCommand commands
// Note: Commands are case sensitive
SerialCommand cmd_version_("V", cmd_version);      // print program name and version
SerialCommand cmd_flush_("F", cmd_flush);          // flush ring buffers
SerialCommand cmd_help_("H", cmd_help);            // print list of commands
SerialCommand cmd_calibrate_("C", cmd_calibrate);  // force calibration
#ifdef GPSDO_PICDIV
  SerialCommand cmd_armpicdiv_("AP", cmd_armpicdiv); // arm and sync picDIV
#endif // PICDIV
SerialCommand cmd_tunnel_("T", cmd_tunnel);        // activate tunnel mode
SerialCommand cmd_rephum_("RH", cmd_rephum);       // activate humand readable reporting
SerialCommand cmd_repdel_("RD", cmd_repdel);       // activate tab delimited reporting
SerialCommand cmd_modehold_("MH", cmd_modehold);   // switch to holdover mode
SerialCommand cmd_modedisc_("MD", cmd_modedisc);   // switch to disciplined mode
SerialCommand cmd_setPWM_("SP", cmd_setPWM);       // note this command takes a 16-bit PWM value (1 to 65535) as an argument
SerialCommand cmd_setalgo_("LA", cmd_setalgo);     // note this command takes a value 0 to 9 as an argument

// 16-bit PWM commands
SerialCommand cmd_up1_("up1", cmd_up1);
SerialCommand cmd_up10_("up10", cmd_up10);
SerialCommand cmd_dp1_("dp1", cmd_dp1);
SerialCommand cmd_dp10_("dp10", cmd_dp10);

#ifdef GPSDO_EEPROM
  SerialCommand cmd_eepromsave_("ES", cmd_eepromsave);  // warning! limited number of writes allowed
  SerialCommand cmd_eepromrecall_("ER", cmd_eepromrecall);
  SerialCommand cmd_eepromerase_("EE", cmd_eepromerase);
#endif // EEPROM

#if (defined (GPSDO_BMP280_SPI) || defined (GPSDO_BMP280_I2C))
  SerialCommand cmd_pressoffset_("PO", cmd_pressoffset);  // set new Pressure Offset value
  SerialCommand cmd_altitoffset_("AO", cmd_altitoffset);  // set new Altitude Offset value
#endif // BMP280

#ifdef GPSDO_TM1637
  SerialCommand cmd_lcltimeoffset_("TO", cmd_lcltimeoffset);  // set UTC to local Time Offset value
#endif // TM1637

// loglevel
uint8_t loglevel = 7;   // see commands comments for log level definitions, default is 7
                        // note log levels are not implemented yet

// Interrupt service routines

// Interrupt Service Routine for TIM2 counter overflow / wraparound
void Timer2_Overflow_ISR(void)
{
  overflowflag = true;
}

// Interrupt Service Routine for TIM2 counter capture
void Timer2_Capture_ISR(void) // WARNING! Do not attempt reading an ADC channel inside the ISR
{
  captureflag = true;
  #ifdef GPSDO_LTIC
    must_read_Vphase = true;  // PPS just occurred so Vphase can be read
  #endif // LTIC
}

// Interrupt Service Routine for the 2Hz timer
void Timer_ISR_2Hz(void) // WARNING! Do not attempt I2C communication inside the ISR

{ // Toggle pin. 2hz toogle --> 1Hz pulse, perfect 50% duty cycle
  digitalWrite(blueledpin, !digitalRead(blueledpin));

  halfsecond = !halfsecond; // true @ 1Hz

  // read TIM2->CCR3 once per second (when captureflag is set) and if it has changed, calculate OCXO frequency
  if (captureflag) {
    lsfcount = TIM2->CCR3; // read TIM2->CCR3
    captureflag = false;   // clear capture flag
    if (flush_ring_buffers_flag) {
      flushringbuffers();   // flush ring buffers after a sat fix loss
    }
    else {
      // check if the frequency counter has been updated and process accordingly
      // there are two possible cases
      // 1. lsfcount is the same as last time -> there is nothing to do, or
      // 2. lsfcount is NOT the same as last time -> process
      if (lsfcount != previousfcount)
      {
        must_adjust_DAC = true; // set flag every time the frequency counter is updated (in principle, once per second)
        ppscount++; // increment our PPS count
        // again we must consider two cases
        // 1. lsfcount < previousfcount -> a wraparound has occurred, process
        // 2. lsfcount > previous fcount -> no wraparound processing required
        if (lsfcount < previousfcount)
        {
          // check wraparound flag, it should be set, if so clear it, otherwise raise error flag
          tim2overflowcounter++;
          if (overflowflag) overflowflag=false; else overflowErrorFlag = true;
        }
        fcount64 = (tim2overflowcounter << 32) + lsfcount; // hehe now we have a 64-bit counter
        if (fcount64 > prevfcount64) {  // if we have a new count - that happens once per second
         if (((fcount64 - prevfcount64) > lowerfcount) && ((fcount64 - prevfcount64) < upperfcount)) { // if we have a valid fcount, otherwise it's discarded
           
           calcfreq64 = fcount64 - prevfcount64;     // the difference is exactly the OCXO frequency in Hz
          
           instant_offset = calcfreq64 - basefreq;   // last measured frequency offset from 10MHz = measured frequency - 10^7
           logfreqoffset();                          // save frequency offset in 8-bit unified ring buffer
         }
        prevfcount64 = fcount64;
        }
      }
      previousfcount = lsfcount; // this happens whether it has changed or not
    }                         
  } // done capture flag
  
  // yellow LED handling
  switch (yellow_led_state)
  {
    case 0:
      // turn off led
      digitalWrite(yellowledpin, LOW);
      break;
    case 1:
      // turn on led
      digitalWrite(yellowledpin, HIGH);
      break;
    case 2:
      // blink led
      digitalWrite(yellowledpin, !digitalRead(yellowledpin));
      break;
    default:
      // default is to turn off led
      digitalWrite(yellowledpin, LOW);
      break; 
  } // done yellow LED
  
  // Uptime clock - in days, hours, minutes, seconds
  if (halfsecond)
  {
      if (++upseconds > 59)
      {
          upseconds = 0;
          if (++upminutes > 59)
          {
              upminutes = 0;
              if (++uphours > 23)
              {
                  uphours = 0;
                  ++updays;
              }
          }
      }
  } // done updating uptime clock
 
} // end of Timer_ISR_2Hz()

void logfreqoffset() {
    // we need to:
    // 1. log the instantaneous frequency offset into the unified ring buffer
    // 2. update the respective cumulative offsets
    // 3. detect when the unified ring buffer has filled with respectively 10s, 100s and 1000s of data,
    //    set the _full flags and handle wraparound
    int8_t temp_offset_save = 0;
    if (co20k_full) temp_offset_save = circbuf_offset[coffset_newest]; // save this value in temporary variable
    
    circbuf_offset[coffset_newest] = instant_offset; // log the instantaneous frequency offset into the unified ring buffer
     
    // now update the respective cumulative offsets
    // that's a little bit more complicated,
    // because when the unified buffer has reached 10s, 100s or 1000s of accumulated data,
    // the oldest offset value must be subtracted and the newest must be added.
    // before these levels are reached, we just add the offset to the cumulative total
    
    cumulten_offset = cumulten_offset + instant_offset;
    cumulhun_offset = cumulhun_offset + instant_offset;
    cumultho_offset = cumultho_offset + instant_offset;
    cumultth_offset = cumultth_offset + instant_offset;
    cumul20k_offset = cumul20k_offset + instant_offset;
    
    // work out what is the index to our -10s, -100s or -1000s old offset data and subtract it

    if (coten_full) { // handle 10s case
      if (coffset_newest >= 10) {
        cumulten_offset = cumulten_offset - circbuf_offset[coffset_newest - 10];
      }
      else { // coffset_newest < 10, so we have wrapped around, we have to add 20000 to our index
        cumulten_offset = cumulten_offset - circbuf_offset[coffset_newest - 10 + 20000];
      }
    }
    
    if (cohun_full) { // handle 100s case
      if (coffset_newest >= 100) {
        cumulhun_offset = cumulhun_offset - circbuf_offset[coffset_newest - 100];
      }
      else { // coffset_newest < 100, so we have wrapped around, we have to add 20000 to our index
        cumulhun_offset = cumulhun_offset - circbuf_offset[coffset_newest - 100 + 20000];
      }
    }

    if (cotho_full) { // handle 1000s case
      if (coffset_newest >= 1000) {
        cumultho_offset = cumultho_offset - circbuf_offset[coffset_newest - 1000];
      }
      else { // coffset_newest < 1000, so we have wrapped around, we have to add 20000 to our index
        cumultho_offset = cumultho_offset - circbuf_offset[coffset_newest - 1000 + 20000];
      }
    }
    
    if (cotth_full) { // handle 10000s case
      if (coffset_newest >= 10000) {
        cumultth_offset = cumultth_offset - circbuf_offset[coffset_newest - 10000];
      }
      else { // coffset_newest < 10000, so we have wrapped around, we have to add 20000 to our index
        cumultth_offset = cumultth_offset - circbuf_offset[coffset_newest - 10000 + 20000];
      }
    }

    if (co20k_full) { // handle 20000s case
      // if co20k_full is true then we subtract the value we saved right at the beginning.
      cumul20k_offset = cumul20k_offset - temp_offset_save;
    }
    
    coffset_newest++;
    
    // did we just fill our unified ring buffer with 10s or 100s or 1000s or 10000s or 20000s of data ?
    if (coffset_newest == 10)  coten_full=true;   // this only needs to happen once, when the unified ring buffer
    if (coffset_newest == 100) cohun_full=true;   // has filled with respectively 10s, 100s, 1000s, 10000s
    if (coffset_newest == 1000)  cotho_full=true; // and 20000s of data
    if (coffset_newest == 10000) cotth_full=true;
    if (coffset_newest == 20000) {
      co20k_full=true;
      coffset_newest = 0;   // (wrap around) - remember coffset_newest is the index 0 to 19999
    }
    // averages recalculation moved to main loop in version v0.06c
    // calcoavg(); // always recalculate averages after logging frequency offset (if the unified buffer has reached respective levels)
  
} // end of logfreqoffset()

void calcoavg() {
  // here we need to calculate the frequency averages oavgften, oavgfhun, oavgftho, etc from the respective cumulative offsets
  // as seen below, this is pretty simple but takes a while because we are dealing with double fp arithmetic.
  if (coten_full) oavgften = double(basefreq) + (double(cumulten_offset) / 10.0);
  if (cohun_full) oavgfhun = double(basefreq) + (double(cumulhun_offset) / 100.0);
  if (cotho_full) oavgftho = double(basefreq) + (double(cumultho_offset) / 1000.0);
  if (cotth_full) oavgftth = double(basefreq) + (double(cumultth_offset) / 10000.0);
  if (co20k_full) oavgf20k = double(basefreq) + (double(cumul20k_offset) / 20000.0);
} // end of calcoavg()

void flushringbuffers(void) {   // reset all frequency counting data structures to their initial state

  prevfcount64 = 0;
  previousfcount = 0;

  coffset_newest = 0;
  
  cumulten_offset = 0;
  cumulhun_offset = 0;
  cumultho_offset = 0; 
  cumultth_offset = 0;
  cumul20k_offset = 0;
   
  coten_full = false;
  cohun_full = false;
  cotho_full = false;
  cotth_full = false;
  co20k_full = false;
  
  oavgften=0;
  oavgfhun=0;
  oavgftho=0;
  oavgftth=0;
  oavgf20k=0;

  ppscount = 0;

  flush_ring_buffers_flag = false; // clear flag
}

void pinModeAF(int ulPin, uint32_t Alternate)
{
   int pn = digitalPinToPinName(ulPin);

   if (STM_PIN(pn) < 8) {
      LL_GPIO_SetAFPin_0_7( get_GPIO_Port(STM_PORT(pn)), STM_LL_GPIO_PIN(pn), Alternate);
   } else {
      LL_GPIO_SetAFPin_8_15(get_GPIO_Port(STM_PORT(pn)), STM_LL_GPIO_PIN(pn), Alternate);
   }

   LL_GPIO_SetPinMode(get_GPIO_Port(STM_PORT(pn)), STM_LL_GPIO_PIN(pn), LL_GPIO_MODE_ALTERNATE);
}

#ifdef GPSDO_UBX_CONFIG
void ubxconfig() // based on code by Brad Burleson
{
  // send UBX commands to set optimal configuration for GPSDO use
  // we are going to change a single parameter from default by
  // setting the navigation mode to "stationary"
  
  bool gps_set_success = false; // flag setting GPS configuration success
  
  // This UBX command sets stationary mode and confirms it
  Serial.println(F("Setting u-Blox M8 receiver navigation mode to stationary: "));
  uint8_t setNav[] = {
    0xB5, 0x62, 0x06, 0x24, 0x24, 0x00, 0xFF, 0xFF, 0x02, 0x03, 0x00, 0x00, 0x00, 0x00, 0x10, 0x27, 0x00, 0x00, 0x05, 0x00, 0xFA, 0x00, 0xFA, 0x00, 0x64, 0x00, 0x2C, 0x01, 0x00, 0x00, 0x00, 0x00, 0x10, 0x27, 0x00, 0x00, 0x00, 0x00, 0x00, 0x00, 0x00, 0x00, 0x49, 0x53};
  while(!gps_set_success)
  {
    sendUBX(setNav, sizeof(setNav)/sizeof(uint8_t));
    Serial.println();
    Serial.println(F("UBX command sent, waiting for UBX ACK... "));
    gps_set_success=getUBX_ACK(setNav);
    if (gps_set_success) 
      Serial.println("Success: UBX ACK received! ");
    else
      Serial.println("Oops, something went wrong here... ");
  }
}

// Send a byte array of UBX protocol to the GPS
void sendUBX(uint8_t *MSG, uint8_t len) {
  for(int i=0; i<len; i++) {
    Serial1.write(MSG[i]);
    Serial.print(MSG[i], HEX);
  }
  Serial1.println();
}

// Calculate expected UBX ACK packet and parse UBX response from GPS
boolean getUBX_ACK(uint8_t *MSG) {
  uint8_t b;
  uint8_t ackByteID = 0;
  uint8_t ackPacket[10];
  unsigned long startTime = millis();
  Serial.print(F(" * Reading ACK response: "));
 
  // Construct the expected ACK packet    
  ackPacket[0] = 0xB5;  // header
  ackPacket[1] = 0x62;  // header
  ackPacket[2] = 0x05;  // class
  ackPacket[3] = 0x01;  // id
  ackPacket[4] = 0x02;  // length
  ackPacket[5] = 0x00;
  ackPacket[6] = MSG[2];  // ACK class
  ackPacket[7] = MSG[3];  // ACK id
  ackPacket[8] = 0;   // CK_A
  ackPacket[9] = 0;   // CK_B
 
  // Calculate the checksums
  for (uint8_t i=2; i<8; i++) {
    ackPacket[8] = ackPacket[8] + ackPacket[i];
    ackPacket[9] = ackPacket[9] + ackPacket[8];
  }
 
  while (1) {
 
    // Test for success
    if (ackByteID > 9) {
      // All packets in order!
      Serial.println(" (SUCCESS!)");
      return true;
    }
 
    // Timeout if no valid response in 3 seconds
    if (millis() - startTime > 3000) { 
      Serial.println(" (FAILED!)");
      return false;
    }
 
    // Make sure data is available to read
    if (Serial1.available()) {
      b = Serial1.read();
 
      // Check that bytes arrive in sequence as per expected ACK packet
      if (b == ackPacket[ackByteID]) { 
        ackByteID++;
        Serial.print(b, HEX);
      } 
      else {
        ackByteID = 0;  // Reset and look again, invalid order
      }
 
    }
  }
}
#endif // UBX_CONFIG

// ---------------------------------------------------------------------------------------------
//    GPSDO tunnel mode (GPS serial is relayed to Bluetooth serial or USB serial)
// --------------------------------------------------------------------------------------------- 
void tunnelgps()
// GPSDO tunnel mode operation
{
  #ifdef GPSDO_BLUETOOTH      // print entering tunnel mode message to either
  Serial2.println();          // Bluetooth serial xor USB serial
  Serial2.print(F("Entering tunnel mode..."));
  Serial2.println();
  #else
  Serial.println();
  Serial.print(F("Entering tunnel mode..."));
  Serial.println();
  #endif // BLUETOOTH

  // tunnel mode operation starts here
  uint32_t endtunnelmS = millis() + (tunnelSecs * 1000);
  uint8_t GPSchar;
  uint8_t PCchar;
  while (millis() < endtunnelmS)
  {
    if (Serial1.available() > 0)
    {
      GPSchar = Serial1.read();
      #ifdef GPSDO_BLUETOOTH
      Serial2.write(GPSchar); // echo GPS NMEA serial stream to Bluetooth serial
      #else      
      Serial.write(GPSchar);  // echo GPS NMEA serial stream to USB serial
      #endif // BLUETOOTH
    }
    #ifdef GPSDO_BLUETOOTH
    if (Serial2.available() > 0)
    #else
    if (Serial.available() > 0)
    #endif // BLUETOOTH
    {
      #ifdef GPSDO_BLUETOOTH
      PCchar = Serial2.read();
      #else
      PCchar = Serial.read();
      #endif // BLUETOOTH
      Serial1.write(PCchar);  // echo USB serial stream to GPS serial
    }
  }
  // tunnel mode operation ends here
  
  #ifdef GPSDO_BLUETOOTH      // print exiting tunnel mode message to either
  Serial2.println();          // Bluetooth serial xor USB serial
  Serial2.print(F("Tunnel mode exited."));
  Serial2.println();
  #else
  Serial.println();
  Serial.print(F("Tunnel mode exited."));
  Serial.println();
  #endif // BLUETOOTH
  
  tunnel_mode_flag = false; // reset flag, exit tunnel mode
} // end of tunnel mode routine

// ---------------------------------------------------------------------------------------------
//    OCXO warmup delay routine (only needed during a GPSDO "cold start")
// ---------------------------------------------------------------------------------------------
void doocxowarmup()
{
  // Spend a few seconds/minutes here just waiting for the OCXO to warmup
  // show countdown timer on OLED or LCD display
  // and report on either USB serial or Bluetooth serial
  // Note: during OCXO warmup the GPSDO does not accept any commands
  uint16_t countdown = ocxo_warmup_time;
  while (countdown) {
              
          #ifdef GPSDO_OLED
          disp.clear();                // display warmup message on OLED
          disp.setCursor(0, 0);
          disp.print(F(Program_Name));
          disp.print(F(" - "));
          disp.print(F(Program_Version));
          disp.setCursor(0, 2);
          disp.print(F("OCXO warming up"));
          disp.setCursor(0, 3);
          disp.print(F("Please wait"));
          disp.setCursor(5, 4);
          disp.print(countdown);
          disp.print(F("s"));
          #endif // OLED
          
          #ifdef GPSDO_LCD_ST7735
          disp.fillScreen(ST7735_BLACK);  // display warmup message on LCD ST7735
          disp.setTextColor(ST7735_CYAN, ST7735_BLACK);
          disp.setTextSize(2);
          disp.setCursor(0, 0);  // X then Y
          // disp.print(F(Program_Name));
          disp.print(F("GPSDO "));  // full Program_Name is too long at that font size
          disp.print(F(Program_Version));
          disp.setCursor(0, 16);
          disp.setTextColor(ST7735_WHITE, ST7735_BLACK);
          disp.setTextSize(1);
          disp.print(F("OCXO warming up"));
          disp.setCursor(0, 24);
          disp.print(F("Please wait"));
          disp.setCursor(0, 32);
          disp.print(countdown);
          disp.print(F("s"));
          #endif // LCD_ST7735
          
          #ifdef GPSDO_LCD_ST7789
            // display OCXO warmup message on ST7789 LCD
            disp_st7789.fillScreen(ST77XX_BLACK); // clear display
            // Display program name and version
            disp_st7789.setTextSize(1);
            disp_st7789.setFont(&FreeMonoBold12pt7b);
            disp_st7789.setTextColor(ST77XX_YELLOW);
            disp_st7789.setCursor(0, 16);
            disp_st7789.print(F("STM32 "));
            disp_st7789.print(F(Program_Name));
            disp_st7789.setTextSize(1);
            disp_st7789.setFont(&FreeMono9pt7b);
            disp_st7789.setTextColor(ST77XX_CYAN);
            disp_st7789.setCursor(168, 11);
            disp_st7789.print(F(Program_Version));
            // display OCXO warming up and countdown
            disp_st7789.setCursor(0, 36);
            disp_st7789.setTextColor(ST77XX_WHITE);
            disp_st7789.print(F("OCXO warming up"));
            disp_st7789.setCursor(0, 50);
            disp_st7789.print(F("Please wait"));
            disp_st7789.setCursor(0, 64);
            disp_st7789.print(countdown);
            disp_st7789.print(F("s"));
            
            must_clear_disp_st7789 = true; 

          #endif // LCD_ST7789
          
          #ifdef GPSDO_BLUETOOTH      // print warmup countdown message to either
            Serial2.println();          // Bluetooth serial xor USB serial
            Serial2.print(F("OCXO Warming up, "));
            Serial2.print(countdown);
            Serial2.println(F("s remaining"));
          #else
            Serial.println();
            Serial.print(F("OCXO Warming up, "));
            Serial.print(countdown);
            Serial.println(F("s remaining"));
          #endif // BLUETOOTH

          // do nothing for 1s
          delay(1000);
          countdown--;
  }
  ocxo_needs_warming = false; // reset flag, next "hot" calibration skips ocxo warmup   
} // end of OCXO warmup routine

// ---------------------------------------------------------------------------------------------
//    GPSDO calibration routine
// --------------------------------------------------------------------------------------------- 
void docalibration()
// OCXO Vctl calibration: find an approximate value for Vctl
{
  yellow_led_state = 2;        // blink yellow LED (handled by 2Hz ISR)
    
  // Note: during calibration the GPSDO does not accept any commands
  #ifdef GPSDO_BLUETOOTH      // print calibration started message to either
  Serial2.println();          // Bluetooth serial xor USB serial
  Serial2.print(F("Calibrating..."));
  Serial2.println();
  #else
  Serial.println();
  Serial.print(F("Calibrating..."));
  Serial.println();
  #endif // BLUETOOTH

  #ifdef GPSDO_OLED
  disp.clear();                // display calibrating message on OLED
  disp.setCursor(0, 0);
  disp.print(F(Program_Name));
  disp.print(F(" - "));
  disp.print(F(Program_Version));
  disp.setCursor(0, 2);
  disp.print(F("Calibrating..."));
  disp.setCursor(0, 3);
  disp.print(F("Please wait"));
  #endif // OLED

  #ifdef GPSDO_LCD_ST7735
  disp.fillScreen(ST7735_BLACK);  // display calibrating message on LCD ST7735
  //delay(700);
  disp.setCursor(0, 0);
  disp.setTextColor(ST7735_CYAN, ST7735_BLACK);
  disp.setTextSize(2);
  //disp.print(F(Program_Name));  // Program_Name is too long, use "GPSDO"
  disp.print(F("GPSDO "));
  disp.print(F(Program_Version));
  disp.setTextSize(1);
  disp.setCursor(0, 16);
  disp.setTextColor(ST7735_WHITE, ST7735_BLACK);
  disp.print(F("Calibrating..."));
  disp.setCursor(0, 24);
  disp.print(F("Wait a few minutes..."));
  #endif // LCD_ST7735

  #ifdef GPSDO_LCD_ST7789
    // display calibrating message on LCD ST7789
    
    disp_st7789.fillScreen(ST77XX_BLACK); // clear display
    
    // display program name and version
    disp_st7789.setTextSize(1);
    disp_st7789.setFont(&FreeMonoBold12pt7b);
    disp_st7789.setTextColor(ST77XX_YELLOW);
    disp_st7789.setCursor(0, 16);
    disp_st7789.print(F("STM32 "));
    disp_st7789.print(F(Program_Name));
    disp_st7789.setTextSize(1);
    disp_st7789.setFont(&FreeMono9pt7b);
    disp_st7789.setTextColor(ST77XX_CYAN);
    disp_st7789.setCursor(168, 11);
    disp_st7789.print(F(Program_Version));
    
    // display calibrating message
    disp_st7789.setCursor(0, 36);
    disp_st7789.setTextColor(ST77XX_WHITE);
    disp_st7789.print(F("Calibrating..."));
    disp_st7789.setCursor(0, 50);
    disp_st7789.print(F("Please wait"));
     
    must_clear_disp_st7789 = true;
  
  #endif // LCD_ST7789

  /*  The calibration algorithm
   *  The objective of the calibration is to find the approximate Vctl to obtain
   *  10MHz +/- 0.1Hz.
   *  
   *  we can use either a PID algorithm or a simple linear interpolation algorithm
   *  
   *  The following describes a simple linear interpolation algorithm
   *  
   *  We first output 1.5V for the DAC or PWM, wait 30 seconds and note the 10s frequency average.
   *  Next we output 2.5V for the DAC or PWM, wait 30 seconds and note the 10s frequency average.
   *  Now we calculate the Vctl for 10MHz +/- 0.1Hz using linear interpolation between the two points.
   */
  // for 12-bit DAC
  // 1.5V for DAC = 4096 x (1.5 / 3.3) = 1862 results in frequency f1 = 10MHz + e1
  // 2.5V for DAC = 4096 x (2.5 / 3.3) = 3103 results in frequency f2 = 10MHz + e2
  // for 16-bit PWM
  // 1.5V for PWM = 65536 x (1.5 / 3.2) = 30720 results in frequency f1 = 10MHz + e1
  // 2.5V for PWM = 65536 x (2.5 / 3.2) = 51200 results in frequency f2 = 10MHz + e2
  // where f2 > f1 (most OCXOs have positive slope).
  
  double f1, f2, e1, e2;
  
  // make sure we have a fix and data
  while (!coten_full) delay(1000); // note there is a small chance that we lose PPS during calibration
                                   // resulting in completely wrong calibration value
  
  // measure frequency for Vctl=1.5V
  Serial.println(F("Measure frequency for Vctl=1.5V"));
  Serial.print(F("Set PWM Vctl to 1.5V, wait ")); Serial.print(ocxo_calib_time); Serial.println(F("s"));
  analogWrite(VctlPWMOutputPin, 30720);
  
  uint16_t calib_countdown = ocxo_calib_time; // note there are two possible values depending on FastBootMode setting
  while (calib_countdown > 0)
    {
      calib_countdown--; 
      Serial.print(calib_countdown); Serial.print(F("s "));
      delay(1000);    
    }  
  
  Serial.println();
  Serial.print(F("f1 (average frequency for Vctl=1.5V): "));
  calcoavg(); // calculate the frequency average
  f1 = oavgften;
  Serial.print(f1,1);
  Serial.println(F(" Hz"));
  Serial.println();
  
  // make sure we have a fix and data again
  while (!coten_full) delay(1000);
  
  // measure frequency for Vctl=2.5V
  Serial.println(F("Measure frequency for Vctl=2.5V"));
  Serial.println(F("Set PWM Vctl to 2.5V, wait ")); Serial.print(ocxo_calib_time); Serial.println(F("s"));
  analogWrite(VctlPWMOutputPin, 51200);
  
  calib_countdown = ocxo_calib_time;  // no need to declare variable again
  while (calib_countdown > 0)
    {
      calib_countdown--; 
      Serial.print(calib_countdown); Serial.print(F("s "));
      delay(1000);    
    }  
  
  Serial.println();
  Serial.print(F("f2 (average frequency for 2.5V Vctl): "));
  calcoavg(); // calculate the frequency average
  f2 = oavgften;
  Serial.print(f2,1);
  Serial.println(F(" Hz"));
  Serial.println();
  
  // slope s is (f2-f1) / (51200-30720) for PWM
  // So F=10MHz +/- 0.1Hz for PWM = 30720 - (e1 / s)
  // set Vctl
  // adjusted_PWM_output = formula
  adjusted_PWM_output = 30720 - ((f1 - 10000000.0) / ((f2 - f1) / 20480));
  Serial.print(F("Calculated PWM: "));
  Serial.println(adjusted_PWM_output);
  analogWrite(VctlPWMOutputPin, adjusted_PWM_output); 
  // calibration done
  
  #ifdef GPSDO_BLUETOOTH      // print calibration finished message to either
    Serial2.println();          // Bluetooth serial xor USB serial
    Serial2.print(F("Calibration done."));
    Serial2.println();
  #else
    Serial.println();
    Serial.print(F("Calibration done."));
    Serial.println();
  #endif // BLUETOOTH

  #ifdef GPSDO_OLED
    disp.clear();             // clear display and show program name and version again
    disp.setCursor(0, 0);
    disp.print(F(Program_Name));
    disp.print(F(" - "));
    disp.print(F(Program_Version)); 
  #endif // OLED
   
  #ifdef GPSDO_LCD_ST7735
    disp.fillScreen(ST7735_BLACK);  
  #endif // LCD_ST7735 
  
  #ifdef GPSDO_LCD_ST7789
    disp_st7789.fillScreen(ST77XX_BLACK);  
  #endif // LCD_ST7789 
  
  yellow_led_state = 0;           // turn off yellow LED (handled by 2Hz ISR)
  flush_ring_buffers_flag = true; // flush the ring buffers (because they now contain invalid data)
  force_calibration_flag = false; // reset flag, calibration done
  #ifdef GPSDO_PICDIV
    must_arm_picDIV = true;         // we have a stable PPS and OCXO is close to 10MHz, so arm picDIV
  #endif // PICDIV
    
} // end of GPSDO calibration routine


bool gpsWaitFix(uint16_t waitSecs)
{
  // waits a specified number of seconds for a fix,
  // returns true as soon as fix available or false on timeout

  uint32_t endwaitmS;
  uint8_t GPSchar;

  if (!report_tab_delimited) {
    #ifdef GPSDO_BLUETOOTH
      Serial2.println();
      //Serial2.print(F("Wait for GPS fix max. "));
      //Serial2.print(waitSecs);
      //if (waitSecs > 1) Serial2.println(F(" seconds")); else Serial2.println(F(" second"));
    #else
      Serial.println();
      //Serial.print(F("Wait for GPS fix max. "));
      //Serial.print(waitSecs);
      //if (waitSecs > 1) Serial.println(F(" seconds")); else Serial.println(F(" second"));
    #endif // Bluetooth  
  }

  endwaitmS = millis() + (waitSecs * 1000);

  while (millis() < endwaitmS)
  {
    if (Serial1.available() > 0)
    {
      GPSchar = Serial1.read();
      gps.encode(GPSchar);
      if (!report_tab_delimited) {
        #ifdef GPSDO_VERBOSE_NMEA
          #ifdef GPSDO_BLUETOOTH
            Serial2.write(GPSchar); // echo NMEA stream to Bluetooth serial
          #else
            Serial.write(GPSchar);  // echo NMEA stream to USB serial
          #endif // Bluetooth
        #endif // VERBOSE_NMEA
      }
    }

    if (gps.location.isUpdated() && gps.altitude.isUpdated() && gps.date.isUpdated())
    {
      endFixmS = millis();                                //record the time when we got a GPS fix
      return true;
    }
  }
  return false;
}

void printGPSDOtab(Stream &Serialx) {       // tab delimited fields suitable for spreadsheet import
  
/*  
 *   STM32 GPSDO reporting tab delimited fields
 *   if any field is not available (e.g. sensor not configured), print "0"

 *   Line no. (0 if no position fix, increments by one each second if position fix)
 *   timestamp (UTC)
 *   uptime (days hours mins secs)
 *   64-bit counter 
 *   frequency (Hz)
 *   10s freq. avg. (one decimal) (Hz)
 *   100s freq. avg. (two decimals) (Hz)
 *   1,000s freq. avg. (three decimals) (Hz)
 *   10,000s freq. avg. (four decimals) (Hz)
 *   20,000s freq. avg. (five decimals) (Hz)
 *   no. of sats
 *   HDOP (meters)
 *   PWM (16-bit, 1-65535)
 *   PWM adc mov. avg. (V)
 *   Vcc adc mov. avg. (5.0V nominal)
 *   Vdd adc mov. avg. (3.3V nominal)
 *   BMP280 Temp. (C)
 *   BMP280 Atm. Pressure (hPa)
 *   AHT20 Temp. (C)
 *   AHT20 Humidity (%)
 *   INA219 OCXO Voltage (5.05V nominal)
 *   INA219 OCXO Current (mA, 2A maximum)
 *   TIC (10-bit, 1024ns max)

 *   When a value is not available, field contains "0".
 */

  report_line_no++;              // increment line number, first line is 1
  
  Serialx.print(report_line_no); // line number
  Serialx.print("\t");           // tab
  
  Serialx.print(day);            // date dd/mm/yyyy
  Serialx.print(F("/"));
  Serialx.print(month);
  Serialx.print(F("/"));
  Serialx.print(year);
  Serialx.print(F(" "));         // <space>

  if (hours < 10) {              // time hh:mm:ss
    Serialx.print(F("0"));
  }
  Serialx.print(hours);
  Serialx.print(F(":"));
  if (mins < 10) {
    Serialx.print(F("0"));
  }
  Serialx.print(mins);
  Serialx.print(F(":"));
  if (secs < 10) {
    Serialx.print(F("0"));
  }
  Serialx.print(secs);
  Serialx.print("\t");           // tab

  Serialx.print(updaysstr);      // uptime 000d hh:mm:ss
  Serialx.print(F(" "));         // <space>
  Serialx.print(uptimestr);
  Serialx.print("\t");           // tab

  Serialx.print(fcount64);       // 64-bit counter
  Serialx.print("\t");           // tab

  Serialx.print(calcfreq64);     // frequency
  Serialx.print("\t");           // tab
  Serialx.print(oavgften,1);     // avg. 10s
  Serialx.print("\t");           // tab
  Serialx.print(oavgfhun,2);     // avg. 100s
  Serialx.print("\t");           // tab
  Serialx.print(oavgftho,3);     // avg. 1,000s
  Serialx.print("\t");           // tab 
  Serialx.print(oavgftth,4);     // avg. 10,000s
  Serialx.print("\t");           // tab
  Serialx.print(oavgf20k,5);     // avg. 20,000s
  Serialx.print("\t");           // tab

  Serialx.print(GPSSats);        // sats
  Serialx.print("\t");           // tab
  
  float tempfloat;               // HDOP 
  tempfloat = ( (float) GPSHdop / 100);
  Serialx.print(tempfloat, 2);
  Serialx.print("\t");           // tab

  Serialx.print(adjusted_PWM_output); // PWM
  Serialx.print("\t");           // tab

  float Vctlp = (float(avgpwmVctl)/4096) * 3.3; // PWM Vctl
  Serialx.print(Vctlp);
  Serialx.print("\t");           // tab

  #ifdef GPSDO_VCC
    // Vcc/2 is provided on pin PA0
    float Vcc = (float(avgVcc)/4096) * 3.3 * 2.0;
    Serialx.print(Vcc);
  #else
    Serialx.print("0");
  #endif // VCC
  Serialx.print("\t");           // tab

  #ifdef GPSDO_VDD
    // internal sensor Vref
    float Vdd = (1.21 * 4096) / float(avgVdd); // from STM32F411CEU6 datasheet
                                               // Vdd = Vref on Black Pill
    Serialx.print(Vdd);
  #else
    Serialx.print("0");
  #endif // VDD
  Serialx.print("\t");           // tab

  #if (defined (GPSDO_BMP280_SPI) || defined (GPSDO_BMP280_I2C))
  // BMP280 measurements
    Serialx.print(bmp280temp, 1);
    Serialx.print("\t");
    Serialx.print(bmp280pres, 1);
  #else
    Serialx.print("0");
    Serialx.print("\t");
    Serialx.print("0");
  #endif // BMP280_SPI
  Serialx.print("\t");           // tab

  #ifdef GPSDO_AHT10
  // AHT10/AHT20 measurements
    sensors_event_t humidity, temp;
    aht.getEvent(&humidity, &temp);// populate temp and humidity objects with fresh data
    Serialx.print(temp.temperature);
    Serialx.print("\t");
    Serialx.print(humidity.relative_humidity);
  #else
    Serialx.print("0");
    Serialx.print("\t");
    Serialx.print("0");  
  #endif // AHT10
  Serialx.print("\t");           // tab

  #ifdef GPSDO_INA219
  // current sensor for the OCXO
    Serialx.print(ina219volt, 2);
    Serialx.print("\t");
    Serialx.print(ina219curr, 0);
  #else
    Serialx.print("0");
    Serialx.print("\t");
    Serialx.print("0");
  #endif // INA219  
  Serialx.print("\t");           // tab

  #ifdef GPSDO_TIC
  // Phase difference in ns, WIP
  #else  
    Serialx.print("0"); 
  #endif // INA219
  
  Serialx.println();           // end of line
  
} // end of printGPSDOtab - tab delimited data output

void printGPSDOstats(Stream &Serialx) {     // human readable output
  
  float tempfloat;
  
  Serialx.print(F("Uptime: "));
  Serialx.print(updaysstr);
  Serialx.print(F(" "));
  Serialx.println(uptimestr);
  
  Serialx.println(F("New GPS Fix: "));

  tempfloat = ( (float) GPSHdop / 100);

  Serialx.print(F("Lat: "));
  Serialx.print(GPSLat, 6);
  Serialx.print(F(" Lon: "));
  Serialx.print(GPSLon, 6);
  Serialx.print(F(" Alt: "));
  Serialx.print(GPSAlt, 1);
  Serialx.println(F("m"));
  Serialx.print(F("Sats: "));
  Serialx.print(GPSSats);
  Serialx.print(F(" HDOP: "));
  Serialx.println(tempfloat, 2);
  Serialx.print(F("UTC Time: "));

  if (hours < 10) {
    Serialx.print(F("0"));
  }
  Serialx.print(hours);
  Serialx.print(F(":"));
  if (mins < 10) {
    Serialx.print(F("0"));
  }
  Serialx.print(mins);
  Serialx.print(F(":"));
  if (secs < 10) {
    Serialx.print(F("0"));
  }
  Serialx.print(secs);
  
  Serialx.print(F(" Date: "));

  Serialx.print(day);
  Serialx.print(F("/"));
  Serialx.print(month);
  Serialx.print(F("/"));
  Serialx.println(year);

  Serialx.println();
  Serialx.println(F("Voltages: "));

  float Vctlp = (float(avgpwmVctl)/4096) * 3.3;
  Serialx.print(F("VctlPWM: "));
  Serialx.print(Vctlp);
  Serialx.print(F("V"));
  Serialx.print(F("  PWM: "));
  Serialx.print(adjusted_PWM_output);
  if (holdover_mode) Serialx.print(F("  OCXO disciplining: OFF (Holdover Mode)"));
  else {
    Serialx.print(F("  OCXO disciplining: ACTIVE"));
    Serialx.print(F("  Trend: ")); // only print the trend if we are disciplining the OCXO
    Serialx.println(trendstr);
  }
  Serialx.println();

  #ifdef GPSDO_VCC
    // Vcc/2 is provided on pin PA0
    float Vcc = (float(avgVcc)/4096) * 3.3 * 2.0;
    Serialx.print(F("Vcc: "));
    Serialx.print(Vcc);
    Serialx.println(F("V"));
  #endif // VCC

  #ifdef GPSDO_VDD
    // internal sensor Vref
    float Vdd = (1.21 * 4096) / float(avgVdd); // from STM32F411CEU6 datasheet
    Serialx.print(F("Vdd: "));                    // Vdd = Vref on Black Pill
    Serialx.print(Vdd);
    Serialx.println(F("V"));
  #endif // VDD

  #ifdef GPSDO_INA219
    // current sensor for the OCXO
    Serialx.print(F("OCXO voltage: "));
    Serialx.print(ina219volt, 2);
    Serialx.println(F("V"));
    Serialx.print(F("OCXO current: "));
    Serialx.print(ina219curr, 0);
    Serialx.println(F("mA"));
  #endif // INA219

  #ifdef GPSDO_LTIC
    // Vphase available on adc channel 1 (PA1)
    Serialx.print(F("Vphase: "));
    Serialx.print(((float(avgVphase)/4096) * 3.3), 2);
    Serialx.println(F("V"));
  #endif // LTIC
      
  // OCXO frequency measurements
  Serialx.println();
  Serialx.println(F("Frequency measurements:"));
  Serialx.print(F("64-bit Counter: "));
  Serialx.println(fcount64);
  Serialx.print(F("Frequency: "));
  if ((calcfreq64 % 1000000) == 0) { // if we have exact frequency, express it in MHz
    Serialx.print(calcfreq64 / 1000000);
    Serialx.print(F(" MHz"));
  }
  else { // else not exact frequency, express it in Hz
    Serialx.print(calcfreq64);
    Serialx.print(F(" Hz")); 
  }
  Serialx.println();
  Serialx.print(F("    10s Frequency Avg: "));
  if (oavgften == 0) Serialx.println(F(" N/A")); else {
      Serialx.print(oavgften,1);
      Serialx.println(F(" Hz"));
  }
  Serialx.print(F("   100s Frequency Avg: "));
  if (oavgfhun == 0) Serialx.println(F(" N/A")); else {
    Serialx.print(oavgfhun,2);
    Serialx.println(F(" Hz"));
  }
  Serialx.print(F(" 1,000s Frequency Avg: "));
  if (oavgftho == 0) Serialx.println(F(" N/A")); else {
    Serialx.print(oavgftho,3);
    Serialx.println(F(" Hz"));
  }
  Serialx.print(F("10,000s Frequency Avg: "));
  if (oavgftth == 0) Serialx.println(F(" N/A")); else {
    Serialx.print(oavgftth,4);
    Serialx.println(F(" Hz"));
  }
  Serialx.print(F("20,000s Frequency Avg: "));
  if (oavgf20k == 0) Serialx.println(F(" N/A")); else {
    Serialx.print(oavgf20k,5);
    Serialx.println(F(" Hz"));
  }  

  #if (defined (GPSDO_BMP280_SPI) || defined (GPSDO_BMP280_I2C))
    // BMP280 measurements
    Serialx.println();
    Serialx.print(F("BMP280 Temperature = "));
    Serialx.print(bmp280temp, 1);
    Serialx.println(" *C");
    Serialx.print(F("Pressure = "));
    Serialx.print(bmp280pres, 1);
    Serialx.println(" hPa");
    Serialx.print(F("Approx altitude = "));
    Serialx.print(bmp280alti, 1); /* Adjusted to local forecast! */
    Serialx.println(" m");
  #endif // BMP280_SPI

  #ifdef GPSDO_AHT10
  // AHT10 measurements
  sensors_event_t humidity, temp;
  aht.getEvent(&humidity, &temp);// populate temp and humidity objects with fresh data
  Serialx.print(F("AHT10 Temperature: "));
  Serialx.print(temp.temperature);
  Serialx.println(F(" *C"));
  Serialx.print(F("Humidity: "));
  Serialx.print(humidity.relative_humidity);
  Serialx.println(F("% rH"));
  #endif // AHT10
  
  Serialx.println();
}

#ifdef GPSDO_OLED
void displayscreen_OLED() // show GPSDO data on OLED display
{
  float tempfloat;

  // blinking Holdover Mode indicator
  disp.setCursor(15, 0);
  if (holdover_mode && ((secs % 2) == 0)) disp.print(F("H")); // indicate Holdover Mode in top right corner
  else disp.print(F(" "));
  // OCXO frequency
  disp.setCursor(0, 1);
  disp.print(F("F "));
  // display 1s, 10s or 100s value depending on whether data is available
  if (coten_full) {
    if (cohun_full) { // if we have data over 100 seconds
      if (oavgfhun < 10000000) {
        disp.setCursor(2, 1); disp.print(" ");
      }
      else disp.setCursor(2, 1);
      disp.print(oavgfhun, 2); // to 2 decimal places
      disp.print("Hz ");
    }
    else { // nope, only 10 seconds
      if (oavgften < 10000000) {
        disp.setCursor(2, 1); disp.print(" ");
      }
      else disp.setCursor(2, 1);
      disp.print(oavgften, 1); // to 1 decimal place
      disp.print("Hz  ");
    }
  }
  else { // we don't have any averages
    calcfreqint = calcfreq64; // convert to 32-bit integer
    if (calcfreqint < 10000000) {
      disp.setCursor(2, 1); disp.print(" ");
    }
    else disp.setCursor(2, 1);
    disp.print(calcfreqint); // integer
    disp.print("Hz    ");
  }

  // Latitude
  //disp.clearLine(2);
  disp.setCursor(0, 2);
  disp.print(GPSLat, 6);
  // Longitude
  //disp.clearLine(3);
  disp.setCursor(0, 3);
  disp.print(GPSLon, 6);
  // Altitude and Satellites
  //disp.clearLine(4);
  disp.setCursor(0, 4);
  disp.print(GPSAlt);
  disp.print(F("m  "));
  disp.setCursor(9, 4);
  disp.print(F("Sats "));
  disp.print(GPSSats);
  if (GPSSats < 10) disp.print(F(" ")); // clear possible digit when sats >= 10
  // HDOP
  //disp.clearLine(5);
  disp.setCursor(0, 5);
  // choose HDOP or uptime
  //disp.print(F("HDOP "));
  //tempfloat = ((float) GPSHdop / 100);
  //disp.print(tempfloat);
  disp.print(F("Up "));  
  disp.print(updaysstr);
  disp.print(F(" "));
  disp.print(uptimestr);

  // Time
  //disp.clearLine(6);
  disp.setCursor(0, 6);

  if (hours < 10)
  {
    disp.print(F("0"));
  }

  disp.print(hours);
  disp.print(F(":"));

  if (mins < 10)
  {
    disp.print(F("0"));
  }

  disp.print(mins);
  disp.print(F(":"));

  if (secs < 10)
  {
    disp.print(F("0"));
  }

  disp.print(secs);
  disp.print(F("  "));

  // Date
  //disp.clearLine(7);
  disp.setCursor(0, 7);

  disp.print(day);
  disp.print(F("/"));
  disp.print(month);
  disp.print(F("/"));
  disp.print(year);

  #if (defined (GPSDO_BMP280_SPI) || defined (GPSDO_BMP280_I2C))
  // BMP280 temperature
  disp.setCursor(10, 6);
  disp.print(bmp280temp, 1);
  disp.print(F("C"));
  #endif // BMP280_SPI

  #ifdef GPSDO_VCC
  disp.setCursor(11, 2);
  // Vcc/2 is provided on pin PA0
  float Vcc = (float(avgVcc)/4096) * 3.3 * 2.0;
  disp.print(Vcc);
  disp.print(F("V"));
  #endif // VCC

  #ifdef GPSDO_VDD
  // internal sensor Vref
  disp.setCursor(11, 3);
  float Vdd = (1.21 * 4096) / float(avgVdd); // from STM32F411CEU6 datasheet                 
  disp.print(Vdd);                           // Vdd = Vref on Black Pill
  disp.print(F("V"));
  #endif // VDD

  disp.setCursor(11, 7); // display PWM/DAC value
  #ifdef GPSDO_PWM_DAC
  disp.print(adjusted_PWM_output);
  #else
  disp.print(adjusted_DAC_output);
  #endif // PWM_DAC
}
#endif // OLED

#ifdef GPSDO_LCD_ST7735
void displayscreen_LCD_ST7735() // show GPSDO data on LCD ST7735 display
                                // we use font1 8x6 pix and font2 16x12 pix
{
  float tempfloat;

  // Latitude
  disp.setCursor(0, 40);
  disp.print(F("Lat: "));
  disp.print(GPSLat, 6);
  // Longitude
  disp.setCursor(0, 48);
  disp.print(F("Lon: "));
  disp.print(GPSLon, 6);
  // Altitude 
  disp.setCursor(0, 56);
  disp.print(F("Alt: "));
  disp.print(GPSAlt);
  disp.print(F("m  "));
  //Satellites
  disp.setCursor(90, 40);
  disp.print(F("Sats: "));
  disp.print(GPSSats);
  if (GPSSats < 10) disp.print(F(" ")); // clear possible digit when sats >= 10
  // HDOP
  disp.setCursor(0, 64);
  // choose HDOP or uptime
  //disp.print(F("HDOP "));
  //tempfloat = ((float) GPSHdop / 100);
  //disp.print(tempfloat);
  disp.print(F("UpT: "));  
  disp.print(updaysstr);
  //disp.print(F(" "));
  disp.setCursor(30, 72);
  disp.print(uptimestr);

  #if (defined (GPSDO_BMP280_SPI) || defined (GPSDO_BMP280_I2C))
  // BMP280 temperature
  disp.setCursor(90, 64);
  disp.print(F(" "));
  disp.print((char)247);
  //disp.print((char)9);
  disp.print(F("C: "));
  disp.print(bmp280temp, 1);
  // BMP280 pressure
  disp.setCursor(90, 72);
  disp.print(F("hPa: "));
  disp.print(bmp280pres, 1);
  #endif // BMP280_SPI

  #ifdef GPSDO_VCC
  disp.setCursor(90, 48);
  // Vcc/2 is provided on pin PA0
  float Vcc = (float(avgVcc)/4096) * 3.3 * 2.0;
  disp.print(F("5V0: "));
  disp.print(Vcc);
  disp.print(F("V"));
  #endif // VCC

  #ifdef GPSDO_VDD
  // internal sensor Vref
  disp.setCursor(90, 56);
  float Vdd = (1.21 * 4096) / float(avgVdd); // from STM32F411CEU6 datasheet                 
  disp.print(F("3V3: "));
  disp.print(Vdd);                           // Vdd = Vref on Black Pill
  disp.print(F("V"));
  #endif // VDD

  disp.setCursor(0, 80);  // display PWM/DAC value
  #ifdef GPSDO_PWM_DAC
    disp.print(F("PWM: "));
    disp.print(adjusted_PWM_output);
    disp.print(F(trendstr));
  #endif // PWM_DAC
  
  // display vref value
  disp.setCursor(90, 80);  // display vref value
  float Vctlp = (float(avgpwmVctl)/4096) * 3.3;
  disp.print(F("Vctl: "));
  disp.print(Vctlp);
  disp.print(F("V"));
  
  // Display Headline and Version
  disp.setTextColor(ST7735_CYAN, ST7735_BLACK);
  disp.setTextSize(2);
  disp.setCursor(0, 0);
  //disp.print(F(Program_Name)); //Program_Name is too long, use "GPSDO"
  disp.print(F("GPSDO "));
  disp.print(F(Program_Version));
  
  // OCXO frequency
  disp.setCursor(0, 19);
  disp.setTextSize(2); 
  disp.setTextColor(ST7735_GREEN, ST7735_BLACK);

  // display 1s, 10s or 100s value depending on whether data is available
  if (coten_full) {
    if (cotho_full) { // if we have data over 1000 seconds
      if (oavgftho < 10000000) {
    disp.print(" ");
        }
        disp.print(oavgftho, 3); // to 3 decimal places
      }
      else if (cohun_full) {
        if (oavgfhun < 10000000) {
      disp.print(" ");
          }
          disp.print(oavgfhun, 2); // to 2 decimal places
        disp.print(" ");
    }

  else { // nope, only 10 seconds
      if (oavgften < 10000000) {
    disp.print(" ");
        }
       disp.print(oavgften, 1); // to 1 decimal place
     disp.print("  ");
    }
  }
  else { // we don't have any averages and print integer value
    calcfreqint = calcfreq64; // convert to 32-bit integer
    if (calcfreqint < 10000000) {
      disp.print(" ");
        }
    disp.print(calcfreqint); // integer
  disp.print("    ");       // these are used for more exact dispaly
    }
  // due to limited space small character unit
  disp.setTextSize(1);
  disp.setCursor(144, 19);
  // due to some unknown issue in printing the freq digits/unit we clear the section of the display first
  disp.fillRect(144, 19, 15, 20, ST7735_BLACK);
  disp.print("Hz");

  // clock and date
  disp.setTextSize(2);
  disp.setTextColor(ST7735_GREEN, ST7735_BLACK);
  // Date
  disp.setCursor(2, 94);
  //disp.print(F("Date: "));  
  disp.print(day);
  disp.print(F("."));
  //disp.print(month);
  disp.print( MonthText[month]); // Using char array to convert month int number to month name string.
  disp.print(F("."));
  disp.print(year);
  
  // Time
  disp.setTextColor(ST7735_GREEN, ST7735_BLACK);
  disp.setCursor(2, 113);

  if (hours < 10)
  {
    disp.print(F("0"));
  }

  disp.print(hours);
  disp.print(F(":"));

  if (mins < 10)
  {
    disp.print(F("0"));
  }

  disp.print(mins);
  disp.print(F(":"));

  if (secs < 10)
  {
    disp.print(F("0"));
  }

  disp.print(secs);
  disp.setTextColor(ST7735_WHITE, ST7735_BLACK);
  disp.print(F(" UTC"));
  
  // reset all font stuff for normal display
  disp.setTextSize(1);
  disp.setTextColor(ST7735_WHITE, ST7735_BLACK);

}
#endif // LCD_ST7735

#ifdef GPSDO_LCD_ST7789
void displayscreen_LCD_ST7789() { // show GPSDO data on LCD ST7789 display
                                  // we use Mono fonts and built-in fonts
  float tempfloat;

  // check if we have to clear the display
  if (must_clear_disp_st7789) {
    disp_st7789.fillScreen(ST77XX_BLACK); // clear display
    must_clear_disp_st7789 = false;       // reset flag
  }
  disp_st7789.fillScreen(ST77XX_BLACK); // clear display
  // Display program name and version
  disp_st7789.setTextSize(1);
  disp_st7789.setFont(&FreeMonoBold12pt7b);
  disp_st7789.setTextColor(ST77XX_YELLOW);
  disp_st7789.setCursor(0, 16);
  disp_st7789.print(F("STM32 "));
  disp_st7789.print(F(Program_Name));
  disp_st7789.setFont(&FreeMono9pt7b);
  disp_st7789.setTextColor(ST77XX_CYAN);
  disp_st7789.setCursor(168, 11);
  disp_st7789.print(F(Program_Version));
    
  // Latitude
  disp_st7789.setTextColor(ST77XX_WHITE);
  disp_st7789.setCursor(2, 60);
  disp_st7789.print(F("Lat: "));
  // disp_st7789.print(GPSLat, 6);
  disp_st7789.print("12.345678 "); // test to see if there is a problem with printing strings vs floats
  // Longitude
  disp_st7789.setCursor(2, 74);
  disp_st7789.print(F("Lon: "));
  disp_st7789.print(GPSLon, 6);
  // Altitude 
  disp_st7789.setCursor(2, 88);
  disp_st7789.print(F("Alt: "));
  disp_st7789.print(GPSAlt, 1);
  disp_st7789.print(F("m  "));
  //Satellites
  disp_st7789.setCursor(140, 88);
  disp_st7789.print(F("Sats: "));
  disp_st7789.print(GPSSats);
  if (GPSSats < 10) disp_st7789.print(F(" ")); // clear possible digit when sats >= 10
  // HDOP
  disp_st7789.setCursor(2, 102);
  disp_st7789.print(F("HDOP: "));
  tempfloat = ((float) GPSHdop / 100);
  disp_st7789.print(tempfloat, 1);
  disp_st7789.setCursor(2, 116);
  disp_st7789.print(F("UpT: "));  
  disp_st7789.print(updaysstr);
  disp_st7789.setCursor(140, 116);
  disp_st7789.print(uptimestr);

  #if (defined (GPSDO_BMP280_SPI) || defined (GPSDO_BMP280_I2C))
    // BMP280 temperature
    disp_st7789.setCursor(2, 130);
    disp_st7789.print(F(" "));
    //disp_st7789.print((char)247);
    //disp_st7789.print((char)9);
    disp_st7789.print(F("*C: "));
    disp_st7789.print(bmp280temp, 1);
    // BMP280 pressure
    disp_st7789.setCursor(2, 144);
    disp_st7789.print(F("hPa: "));
    disp_st7789.print(bmp280pres, 1);
  #endif // BMP280_SPI

  #ifdef GPSDO_VCC
    disp_st7789.setCursor(2, 160);
    // Vcc/2 is provided on pin PA0
    float Vcc = (float(avgVcc)/4096) * 3.3 * 2.0;
    disp_st7789.print(F("5V0: "));
    disp_st7789.print(Vcc, 2);
    disp_st7789.print(F("V"));
  #endif // VCC

  #ifdef GPSDO_VDD
    // internal sensor Vref
    disp_st7789.setCursor(2, 174);
    float Vdd = (1.21 * 4096) / float(avgVdd); // from STM32F411CEU6 datasheet                 
    disp_st7789.print(F("3V3: "));
    disp_st7789.print(Vdd, 2);                    // Vdd = Vref on Black Pill
    disp_st7789.print(F("V"));
  #endif // VDD
/*
  disp_st7789.setCursor(0, 80);  // display PWM/DAC value
  #ifdef GPSDO_PWM_DAC
    disp_st7789.print(F("PWM: "));
    disp_st7789.print(adjusted_PWM_output);
    disp_st7789.print(F(trendstr));
  #endif // PWM_DAC
  
  // display Vctl value
  disp_st7789.setCursor(90, 80);  // display Vctl value
  float Vctlp = (float(avgpwmVctl)/4096) * 3.3;
  disp_st7789.print(F("Vctl: "));
  disp_st7789.print(Vctlp);
  disp_st7789.print(F("V"));
*/  
  // OCXO frequency
  disp_st7789.setFont();          // reset font to built-in
  disp_st7789.setTextSize(2);
  disp_st7789.setCursor(10, 24);
  disp_st7789.setTextColor(ST77XX_RED, ST77XX_BLACK);

  // display 1s, 10s or 100s value depending on whether data is available
  if (coten_full) {
    if (cotho_full) { // if we have data over 1000 seconds
      if (oavgftho < 10000000) {
        disp_st7789.print(" ");
      }
      disp_st7789.print(oavgftho, 3); // to 3 decimal places
    }
      else if (cohun_full) {
        if (oavgfhun < 10000000) {
      disp_st7789.print(" ");
          }
          disp_st7789.print(oavgfhun, 2); // to 2 decimal places
        disp_st7789.print(" ");
    }

  else { // nope, only 10 seconds
    if (oavgften < 10000000) {
      disp_st7789.print(" ");
    }
    disp_st7789.print(oavgften, 1); // to 1 decimal place
    disp_st7789.print("  ");
    }
  }
  else { // we don't have any averages and print integer value
    calcfreqint = calcfreq64;       // convert to 32-bit integer
    if (calcfreqint < 10000000) {
      disp_st7789.print(" ");
    }
    disp_st7789.print(calcfreqint); // integer
  disp_st7789.print("    ");        // these are used for more exact display
  }
  // due to limited space small character unit
  // disp_st7789.setTextSize(1);
  // disp_st7789.setCursor(168, 20);
  // due to some unknown issue in printing the freq digits/unit we clear the section of the display first
  // disp_st7789.fillRect(144, 19, 15, 20, ST77XX_BLACK);
  disp_st7789.print(" Hz");

  // clock and date
  disp_st7789.setTextSize(2);
  disp_st7789.setTextColor(ST77XX_MAGENTA, ST77XX_BLACK);
  // Date
  disp_st7789.setCursor(2, 188);
  //disp_st7789.print(F("Date: "));  
  disp_st7789.print(day);
  disp_st7789.print(F("."));
  disp_st7789.print(month);
  disp_st7789.print(F("."));
  disp_st7789.print(year);
  
  // Time
  disp_st7789.setTextColor(ST77XX_GREEN, ST77XX_BLACK);
  disp_st7789.setCursor(2, 208);

  if (hours < 10) {
    disp_st7789.print(F("0"));
  }
  disp_st7789.print(hours);
  disp_st7789.print(F(":"));

  if (mins < 10) {  
    disp_st7789.print(F("0"));
  }
  disp_st7789.print(mins);
  disp_st7789.print(F(":"));

  if (secs < 10) {  
    disp_st7789.print(F("0"));
  }
  disp_st7789.print(secs);
  
  disp_st7789.setTextColor(ST77XX_WHITE, ST77XX_BLACK);
  disp_st7789.print(F(" UTC"));
  
  // reset all font stuff for normal display
  // disp_st7789.setFont();
  // disp_st7789.setTextSize(1);
  // disp_st7789.setTextColor(ST77XX_WHITE, ST77XX_BLACK);
}
#endif // LCD_ST7789

#ifdef GPSDO_TM1637
  void displaytime_TM1637() {
    int tmhours = hours;
    if (showlocaltime) {  // calculate and show local time
      tmhours += timeoffset;
      if (tmhours >= 24) tmhours -= 24; // handle wraparound cases
      else if (tmhours < 0) tmhours += 24;
    }
    int LEDtime = (tmhours * 100) + mins;
    // Show UTC or local time on TM1637 4-digit LED display and blink colon at 1Hz
    if ((secs%2) == 0) tm1637.showNumberDecEx(LEDtime, 0b11100000, true);
    else tm1637.showNumberDec(LEDtime, true);
  }
#endif // TM1637

void uptimetostrings() {
  // translate uptime variables to strings
  uptimestr[0] = '0' + uphours / 10;
  uptimestr[1] = '0' + uphours % 10;
  uptimestr[3] = '0' + upminutes / 10;
  uptimestr[4] = '0' + upminutes % 10;
  uptimestr[6] = '0' + upseconds / 10;
  uptimestr[7] = '0' + upseconds % 10;
 
  if (updays > 99) { // 100 days or more
    updaysstr[0] = '0' + updays / 100;
    updaysstr[1] = '0' + (updays % 100) / 10;
    updaysstr[2] = '0' + (updays % 100) % 10;
  }
  else { // less than 100 days
    updaysstr[0] = '0';
    updaysstr[1] = '0' + updays / 10;
    updaysstr[2] = '0' + updays % 10;
  }
} // end of uptimetostrings()

// ---------------------------------------------------------------------------------------------
//    readvphase routine, reads the voltage on the TIC capacitor and averages it
// --------------------------------------------------------------------------------------------- 
#ifdef GPSDO_LTIC
  // read Vphase and discharge 1nF TIC capacitor
  void readvphase() {
    adcVphase = analogRead(VphaseInputPin);
    avgVphase = avg_adcVphase.reading(adcVphase);
    pinMode(VphaseInputPin, OUTPUT_OPEN_DRAIN);   // setup PA1 as output open drain pin
    digitalWrite(VphaseInputPin, LOW);            // pulse pin low to discharge capacitor
    delay(DischargeTime);
    digitalWrite(VphaseInputPin, HIGH);
    pinMode(VphaseInputPin, INPUT_ANALOG);        // setup PA1 as analog input pin
  }
#endif // LTIC
    
// ---------------------------------------------------------------------------------------------
//    setup routine, prepares the hardware for normal operation
// --------------------------------------------------------------------------------------------- 
void setup()
{
  // Wait 1/2 second for things to stabilize
  delay(500);

  active_cla = default_cla;             // set active control loop algorithm to default

  #ifdef GPSDO_PICDIV
    pinMode(picDIVarmPin, OUTPUT);      // pin used to arm the picDIV
    digitalWrite(picDIVarmPin, HIGH);   // arming done by pulsing this low for > 1s
  #endif // PICDIV


  // check if we have a signature in flash
  #ifdef GPSDO_EEPROM
    sigalreadywritten = true;
    eeprom_buffer_fill(); // fill the buffer with contents of Flash emulating EEPROM
    for (uint8_t csig = 0; csig < 6; csig++) {
      if (eeprom_buffered_read_byte(csig) != signature[csig]) sigalreadywritten = false;
    }
  #endif // EEPROM  

  // setup 2kHz test signal on PB5, can be tested with an oscilloscope
  #ifdef GPSDO_GEN_2kHz_PB5                 // note this uses Timer 3 Channel 2
    analogWrite(Test2kHzOutputPin, 127);    // configures PB5 as PWM output pin at default frequency and resolution
    analogWriteFrequency(2000);             // default PWM frequency is 1kHz, change it to 2kHz
    analogWriteResolution(16);              // default PWM resolution is 8 bits, change it to 16 bits
    analogWrite(Test2kHzOutputPin, 32767);  // 32767 for 16 bits -> 50% duty cycle so a square wave
  #endif // GEN_2kHz_PB5
   
  // configure blueledpin in output mode
  pinMode(blueledpin, OUTPUT);    // blinking blue LED indicates interrupts are working

  // configure yellow_led_pin in output mode 
  pinMode(yellowledpin, OUTPUT);  // yellow LED is used to indicate status of the GPSDO  
  
  // Setup 2Hz Timer and its interrupt service routine
  HardwareTimer *tim2Hz = new HardwareTimer(TIM9);
  tim2Hz->setOverflow(2, HERTZ_FORMAT); // 2 Hz
  tim2Hz->attachInterrupt(Timer_ISR_2Hz);
  tim2Hz->resume();

  // Setup UART (serial) interfaces
  Serial.begin(115200);      // USB serial
  Serial1.begin(9600);       // Hardware serial 1 to GPS module
  #ifdef GPSDO_BLUETOOTH
    // HC-06 module baud rate factory setting is 9600, 
    // IMPORTANT! Use separate program to set baud rate to 57600
    Serial2.begin(BT_BAUD); // Hardware serial 2 to Bluetooth module
  #endif // BLUETOOTH

  Serial.println();
  Serial.println(F(Program_Name));
  Serial.println(F(Program_Version));
  Serial.println();
  #ifdef GPSDO_EEPROM
    if (sigalreadywritten) {
      Serial.println(F("STM32 signature found in flash, using stored PWM DAC value"));
      force_calibration_flag = false; // if using stored PWM value, skip calibration
    }
    else
      Serial.println(F("STM32 signature not found in flash"));
  #endif // EEPROM
  Serial.println(F("2Hz interrupt configured"));    
  Serial.println(F("Serial interfaces configured"));    

  // setup commands parser
  serial_commands_.SetDefaultHandler(cmd_unrecognized);
  serial_commands_.AddCommand(&cmd_version_);   // prints program name and version
  serial_commands_.AddCommand(&cmd_flush_);     // flush ring buffer
  serial_commands_.AddCommand(&cmd_help_);      // print list of commands
  serial_commands_.AddCommand(&cmd_calibrate_); // perform calibration
  #ifdef GPSDO_PICDIV
    serial_commands_.AddCommand(&cmd_armpicdiv_); // arm and sync picDIV
  #endif // PICDIV
  serial_commands_.AddCommand(&cmd_tunnel_);    // enter tunnel mode (exits automatically after delay)
  serial_commands_.AddCommand(&cmd_setPWM_);    // set 16-bit PWM value manually
  serial_commands_.AddCommand(&cmd_setalgo_);   // set active control loop algorithm (0 to 9)
  serial_commands_.AddCommand(&cmd_rephum_);    // human readable reporting (default)
  serial_commands_.AddCommand(&cmd_repdel_);    // tab delimited reporting (for spreadsheet import)
  serial_commands_.AddCommand(&cmd_modehold_);  // enter holdover mode, OCXO not disciplined
  serial_commands_.AddCommand(&cmd_modedisc_);  // exit holdover mode, normal operation
  
  serial_commands_.AddCommand(&cmd_up1_);
  serial_commands_.AddCommand(&cmd_up10_);
  serial_commands_.AddCommand(&cmd_dp1_);
  serial_commands_.AddCommand(&cmd_dp10_);

  #ifdef GPSDO_EEPROM
    serial_commands_.AddCommand(&cmd_eepromsave_);    // sign EEPROM and save PWM value
    serial_commands_.AddCommand(&cmd_eepromrecall_);  // set PWM value from EEPROM if EEPROM signed
    serial_commands_.AddCommand(&cmd_eepromerase_);   // delete signature in EEPROM
  #endif // EEPROM

  #if (defined (GPSDO_BMP280_SPI) || defined (GPSDO_BMP280_I2C))
    serial_commands_.AddCommand(&cmd_pressoffset_);  // set new Pressure Offset value
    serial_commands_.AddCommand(&cmd_altitoffset_);  // set new Altitude Offset value
  #endif // BMP280

  #ifdef GPSDO_TM1637
    serial_commands_.AddCommand(&cmd_lcltimeoffset_); // set new UTC to local Time Offset value
  #endif // TM1637

  Serial.println(F("Commands parser configured"));    
    
  #ifdef GPSDO_LCD_ST7735
    // Setup LCD SPI ST7735 display 
    //  If needed: Set SP1 alternate pin usage per "#defines" at the top
    //  SPI.setSCLK(TFT_SCLK);
    //  SPI.setMOSI(TFT_MOSI);
    SPI.setClockDivider(SPI_CLOCK_DIV16);
    SPI.begin();  
    disp.initR(INITR_GREENTAB); //Your LCD might need disp.initR(INITR_BLACKTAB); // 1.8" LCD
    delay(500);
    disp.fillScreen(ST7735_BLACK);
    disp.setRotation(1);   // 0..3 max, here we use 90° = landscape
    disp.setFont();
    disp.setTextSize(2);
    // splash screen
    disp.setCursor(45, 30);
    disp.setTextColor(ST7735_GREEN, ST7735_BLACK); 
    disp.print(F(Program_Name));
    // disp.setTextSize(1);
    disp.setCursor(40, 65);
    // disp.print(F(" - "));
    disp.setTextColor(ST7735_GREEN, ST7735_BLACK);
    disp.print(F(Program_Version));
    disp.setTextColor(ST7735_WHITE, ST7735_BLACK);
    disp.setTextSize(1);

    Serial.println(F("ST7735 LCD display configured"));
  #endif // LCD_ST7735

  // Setup LCD SPI ST7789 display
  #ifdef GPSDO_LCD_ST7789
    disp_st7789.init(240, 240, SPI_MODE3); // 1.3" 240x240 TFT LCD
    delay(100);
    disp_st7789.fillScreen(ST77XX_BLACK);
    disp_st7789.setRotation(2);   // 0..3 max, 1 = 90° = landscape
    // Display program name and version
    disp_st7789.setTextSize(1);
    disp_st7789.setFont(&FreeMonoBold12pt7b);
    disp_st7789.setTextColor(ST77XX_YELLOW);
    disp_st7789.setCursor(0, 16);
    disp_st7789.print(F("STM32 "));
    disp_st7789.print(F(Program_Name)); // program name
    disp_st7789.setFont(&FreeMono9pt7b);
    disp_st7789.setTextColor(ST77XX_CYAN);
    disp_st7789.setCursor(168, 11);
    disp_st7789.print(F(Program_Version)); // program version

    Serial.println(F("ST7789 LCD display configured"));
  #endif // LCD_ST7789

  // Setup TM1637 4-digit LED module
  #ifdef GPSDO_TM1637
    // Set the display brightness (0-7):
    tm1637.setBrightness(5);
    // Clear the display:
    tm1637.clear();
    tm1637.setSegments(mid_dashes);

    Serial.println(F("TM1637 4-digit LED clock display configured"));
  #endif // TM1637

  #ifdef GPSDO_UBX_CONFIG
    // Reconfigure the GPS receiver
    // first send the $PUBX configuration commands
    delay(3000); // give everything a moment to stabilize
    Serial.println("GPS checker program started");
    Serial.println("Sending $PUBX commands to GPS");  
    // first send the $PUBG configuration commands
    Serial1.print("$PUBX,40,VTG,0,0,0,0,0,0*5E\r\n"); // disable all VTG messages (useless since we are stationary)
    Serial1.print("$PUBX,41,1,0003,0003,38400,0*24\r\n"); // set GPS baud rate to 38400 in/out protocols NMEA+UBX
    Serial1.flush();                              // empty the buffer
    delay(100);                                   // give it a moment
    Serial1.end();                                // close serial port
    Serial1.begin(38400);                         // re-open at new rate
    delay(3000);
    // second, send the proprietary UBX configuration commands
    Serial.println("Now sending UBX commands to GPS");
    ubxconfig();

    Serial.println(F("u-blox GPS module configured"));  
  #endif // UBX_CONFIG

  // Setup AHT10 / AHT20 temperature and humidity sensor module
  #ifdef GPSDO_AHT10 // same code for AHT20
    Serial.println(F("Testing for presence of AHT10 or AHT20 Sensor on I2C bus"));
    if (!aht.begin()) {
      Serial.println(F("Could not find AHT10 or AHT20 sensor, check wiring"));
      while (1) delay(10);
    }
    else Serial.println(F("AHTX0 sensor configured"));
  #endif // AHT10 - Note this seems to initialize the I2C bus interface

  // Setup OLED I2C display
  #ifdef GPSDO_OLED
    // Note that u8x8 library initializes I2C hardware interface
    // disp.setBusClock(400000L); // try to avoid display locking up
    disp.begin();
    disp.setFont(u8x8_font_chroma48medium8_r);
    disp.clear();
    disp.setCursor(0, 0);
    disp.print(F(Program_Name));
    disp.print(F(" - "));
    disp.print(F(Program_Version));

    Serial.println(F("OLED display configured"));
  #endif // OLED 
  
  // Setup INA219 current sensor module
  #ifdef GPSDO_INA219
    // By default the initialization will use the largest range (32V, 2A).  However
    // you can call a setCalibration function to change this range (see comments).
    if (! ina219.begin()) {
      Serial.println(F("Could not find INA219 sensor, check wiring"));
      while (1) { delay(10); }
    }
    else Serial.println(F("INA219 sensor configured"));
    // To use a slightly lower 32V, 1A range (higher precision on amps):
    //ina219.setCalibration_32V_1A();
    // Or to use a lower 16V, 400mA range (higher precision on volts and amps):
    //ina219.setCalibration_16V_400mA();
    ina219.setCalibration_32V_1A();
  #endif // INA219 
   
  analogReadResolution(12); // make sure we read 12 bit values when we read from any ADC analog channel 

  // generate a 2kHz square wave on PB9 PWM pin, using Timer 4 channel 4
  // PB9 is Timer 4 Channel 4 from Arduino_Core_STM32/variants/STM32F4xx/F411C(C-E)(U-Y)/PeripheralPins_BLACKPILL_F411CE.c
  analogWrite(VctlPWMOutputPin, 127);                   // configures PB9 as PWM output pin at default frequency and resolution
  analogWriteFrequency(2000);                           // default PWM frequency is 1kHz, change it to 2kHz
  analogWriteResolution(16);                            // set PWM resolution to 16 bits (the maximum for the STM32F411CEU6)
  #ifdef GPSDO_EEPROM
    if (sigalreadywritten)
      adjusted_PWM_output = (256 * eeprom_buffered_read_byte(6)) + eeprom_buffered_read_byte(7);  // saved PWM value
    else
      adjusted_PWM_output = default_PWM_output;             // initial PWM value
  #else
    adjusted_PWM_output = default_PWM_output;             // initial PWM value
  #endif // EEPROM
  analogWrite(VctlPWMOutputPin, adjusted_PWM_output);   // 32767 for 16 bits -> 50% duty cycle so a square wave
  Serial.println(F("16-bit PWM DAC configured"));

  #if (defined (GPSDO_BMP280_SPI) || defined (GPSDO_BMP280_I2C))
  // Initialize BMP280
  Serial.println(F("Testing for presence of BMP280 Sensor on I2C bus"));
  #ifdef GPSDO_BMP280_I2C // BMP280 on I2C bus requires specifying address
    if (!bmp.begin(0x76,0x58)) {
  #else
    if (!bmp.begin()) {
  #endif
      Serial.println(F("Could not find BMP280 sensor, check wiring"));
      while (1) delay(10);
    }
    else Serial.println(F("BMP280 sensor configured"));
  
    // Default settings from datasheet
    bmp.setSampling(Adafruit_BMP280::MODE_NORMAL,     // Operating Mode 
                  Adafruit_BMP280::SAMPLING_X2,        // Temp. oversampling
                  Adafruit_BMP280::SAMPLING_X16,       // Pressure oversampling
                  Adafruit_BMP280::FILTER_X16,         // Filtering
                  Adafruit_BMP280::STANDBY_MS_500);    // Standby time

  #endif // BMP280_SPI or BMP280_I2C
  
  // Setup and start Timer 2 which measures OCXO frequency
  // setup pin used as ETR (10MHz external clock from OCXO)
  pinMode(PA15, INPUT_PULLUP);    // setup PA15 as input pin
  pinModeAF(PA15, GPIO_AF1_TIM2); // setup PA15 as TIM2 channel 1 / ETR
  
  // setup Timer 2 in input capture mode, active input channel 3
  // to latch counter value on rising edge

  // Instantiate HardwareTimer object. Thanks to 'new' instantiation, HardwareTimer is not destructed when setup() function is finished.
  HardwareTimer *FreqMeasTim = new HardwareTimer(TIM2);
  
  // Configure rising edge detection to measure frequency
  FreqMeasTim->setMode(3, TIMER_INPUT_CAPTURE_RISING, PB10);

  // Configure 32-bit auto-reload register (ARR) with maximum possible value
  TIM2->ARR = 0xffffffff; // count to 2^32, then wraparound (approximately every 429 seconds)

  // Configure the ISR for the timer overflow interrupt
  FreqMeasTim->attachInterrupt(Timer2_Overflow_ISR);
  
  // Configure the ISR for the 1PPS capture
  FreqMeasTim->attachInterrupt(3, Timer2_Capture_ISR);  

  // select external clock source mode 2 by writing ECE=1 in the TIM2_SMCR register
  TIM2->SMCR |= TIM_SMCR_ECE; // 0x4000
  
  // start the timer
  FreqMeasTim->resume();

  // Initialize movingAvg objects (note this allocates space on heap) and immediately read 1st value
  #ifdef GPSDO_LTIC
    avg_adcVphase.begin();
    adcVphase = analogRead(VphaseInputPin);
    avgVphase = avg_adcVphase.reading(adcVphase);
  # endif // LTIC
  
  #ifdef GPSDO_VDD
    avg_adcVdd.begin();
    adcVdd = analogRead(AVREF);
    avgVdd = avg_adcVdd.reading(adcVdd);
  # endif // VDD
  
  #ifdef GPSDO_VCC
    avg_adcVcc.begin();
    adcVcc = analogRead(VccDiv2InputPin);
    avgVcc = avg_adcVcc.reading(adcVcc);
  # endif // VCC
  
  avg_pwmVctl.begin();
  pwmVctl = analogRead(VctlPWMInputPin);
  avgpwmVctl = avg_pwmVctl.reading(pwmVctl);

  #ifdef GPSDO_EEPROM
    if (sigalreadywritten) Serial.println(F("EEPROM signature detected, skipping calibration"));
    else Serial.println(F("No EEPROM signature"));
  #endif // EEPROM

  startGetFixmS = millis();
    
  Serial.println();
  Serial.println(F("GPSDO Starting"));
  Serial.println();

} // end of setup()


// ---------------------------------------------------------------------------------------------
//    loop routine: this is the main loop
// --------------------------------------------------------------------------------------------- 
void loop()
{
  serial_commands_.ReadSerial();  // process any command from either USB serial (usually 
                                  // the Arduino monitor) xor Bluetooth serial (e.g. a smartphone)

  if (ocxo_needs_warming) doocxowarmup();                                 
                                  
  #ifdef GPSDO_EEPROM
    if (!sigalreadywritten)
      if (force_calibration_flag) docalibration();
  #else
    if (force_calibration_flag) docalibration();
  #endif // EEPROM 
  
  if (tunnel_mode_flag) tunnelgps(); else
  
  if (gpsWaitFix(waitFixTime))    // wait up to waitFixTime seconds for fix, returns true if we have a fix
  { 
    // if we have a GPS fix (implies we have a stable 1PPS pulse from the GPS)

    #ifdef GPSDO_PICDIV
      if (must_arm_picDIV) {              // sync picDIV if it was requested
        digitalWrite(picDIVarmPin, LOW);  // pulse pin low to arm picDIV
        arming_started = millis();
        must_arm_picDIV = false;   
      }
    #endif // PICDIV

    #ifdef GPSDO_LTIC
      // Before anything else, read Vphase and discharge 1nF TIC capacitor
      if (must_read_Vphase) readvphase();
    #endif // LTIC
    
    if (!report_tab_delimited) { // only report fix time when in human readable output format mode
      #ifdef GPSDO_BLUETOOTH
        Serial2.println();
        Serial2.println();
        Serial2.print(F("Fix time "));
        Serial2.print(endFixmS - startGetFixmS);
        Serial2.println(F("ms"));
      #else
        Serial.println();
        Serial.println();
        Serial.print(F("Fix time "));
        Serial.print(endFixmS - startGetFixmS);
        Serial.println(F("ms"));
      #endif // BLUETOOTH
    } // !report_tab_delimited

    GPSLat = gps.location.lat();
    GPSLon = gps.location.lng();
    GPSAlt = gps.altitude.meters();
    GPSSats = gps.satellites.value();
    GPSHdop = gps.hdop.value();

    hours = gps.time.hour();
    mins = gps.time.minute();
    secs = gps.time.second();
    day = gps.date.day();
    month = gps.date.month();
    year = gps.date.year();


    if (must_adjust_DAC && cohun_full && !holdover_mode) { // period depends on algorithm,
                                                           // only if we have valid data
                                                           // and only if we are in disciplined mode
      uint16_t old_adjusted_PWM_output = adjusted_PWM_output;  // save old value
      adjusted_PWM_output = adjustVctlPWM(old_adjusted_PWM_output, ppscount, active_cla); // compute new value for PWM DAC
      // write the computed value to PWM DAC only if different from old value
      if (adjusted_PWM_output != old_adjusted_PWM_output) analogWrite(VctlPWMOutputPin, adjusted_PWM_output);
      must_adjust_DAC = false; // clear flag since we are done
    }

    pwmVctl = analogRead(VctlPWMInputPin);      // read the filtered Vctl voltage output by the PWM
    avgpwmVctl = avg_pwmVctl.reading(pwmVctl);  // average it

    #ifdef GPSDO_VCC
      adcVcc = analogRead(VccDiv2InputPin);       // read Vcc
      avgVcc = avg_adcVcc.reading(adcVcc);        // average it
    # endif // VCC

    #ifdef GPSDO_VDD
      adcVdd = analogRead(AVREF);                 // Vdd is read internally as Vref
      avgVdd = avg_adcVdd.reading(adcVdd);        // average it
    #endif // VDD    

    #if (defined (GPSDO_BMP280_SPI) || defined (GPSDO_BMP280_I2C))
      bmp280temp = bmp.readTemperature();                       // read bmp280 sensor, save values
      bmp280pres = (bmp.readPressure()+PressureOffset)/100;     // apply PressureOffset here and calculate value in hPa
      bmp280alti = bmp.readAltitude(bmp280pres+AltitudeOffset); // apply AltitudeOffset here
    #endif // BMP280_SPI or BMP280_SPI   

    #ifdef GPSDO_INA219
      ina219volt = ina219.getBusVoltage_V();           // read ina219 sensor, save values
      ina219curr = ina219.getCurrent_mA();
    #endif // INA219 
  
    uptimetostrings();            // get updaysstr and uptimestr

    yellow_led_state = 0;         // turn off yellow LED

    calcoavg();                   // calculate the frequency averages

    if (report_tab_delimited) {   // check what to print and where
      #ifdef GPSDO_BLUETOOTH
        printGPSDOtab(Serial2);   // print tabulated data to Bluetooth Serial
      #else                       // xor
        printGPSDOtab(Serial);    // print tabulated data to USB Serial
      #endif // BLUETOOTH
    }
    else {
      #ifdef GPSDO_BLUETOOTH
        printGPSDOstats(Serial2);   // print stats to Bluetooth Serial
      #else                         // xor
        printGPSDOstats(Serial);    // print stats to USB Serial
      #endif // BLUETOOTH
    } // end if (report_tab_delimited)

    #ifdef GPSDO_OLED             // show stats on various displays
      displayscreen_OLED();
    #endif // OLED

    #ifdef GPSDO_LCD_ST7735
      displayscreen_LCD_ST7735();
    #endif // LCD_ST7735  
    
    #ifdef GPSDO_LCD_ST7789
      displayscreen_LCD_ST7789();
    #endif // LCD_ST7789  
    
    #ifdef GPSDO_TM1637
      displaytime_TM1637();
    #endif // TM1637  
    
    startGetFixmS = millis();    // have a fix, next thing that happens is checking for a fix, so restart timer

    #ifdef GPSDO_PICDIV
      if (arming_started > 0) {               // if arm picDIV ongoing
        if ((millis() - arming_started) > picdivArmDelay) {
          digitalWrite(picDIVarmPin, HIGH);   // end low pulse after > 1s elapsed
          arming_started = 0;
        }   
      }
   #endif // PICDIV
  }
  else // no GPS fix could be acquired for the last 1/2/5 seconds (see settings)
  {
    // we don't have a GPS fix, so we consider that we don't have a stable 1PPS
    yellow_led_state = 1;        // turn on yellow LED to show something is not right
    
    #ifdef GPSDO_OLED
      disp.clear();                // display no fix message on OLED
      disp.setCursor(0, 0);
      disp.print(F(Program_Name));
      disp.print(F(" - "));
      disp.print(F(Program_Version));
      disp.setCursor(0, 1);
      disp.print(F("Wait fix "));
      disp.print( (millis() - startGetFixmS) / 1000 );
      disp.print(F("s"));
    #endif // OLED

    #ifdef GPSDO_LCD_ST7735
      disp.fillScreen(ST7735_BLACK);  // display no fix message on ST7735 LCD
      disp.setCursor(0, 0);
      // disp.print(F(Program_Name)); Program_Name is too long for this LCD, use "GPSDO"
      disp.print(F("GPSDO "));
      // disp.print(F(" - "));
      disp.print(F(Program_Version));
      disp.setCursor(0, 8);
      disp.print(F("Wait fix "));
      disp.print( (millis() - startGetFixmS) / 1000 );
      disp.print(F("s"));
    #endif // LCD_ST7735

    #ifdef GPSDO_LCD_ST7789
      // display no fix message on ST7789 LCD
      disp_st7789.fillScreen(ST77XX_BLACK); // clear display
      // Display program name and version
      disp_st7789.setTextSize(1);
      disp_st7789.setFont(&FreeMonoBold12pt7b);
      disp_st7789.setTextColor(ST77XX_YELLOW);
      disp_st7789.setCursor(0, 16);
      disp_st7789.print(F("STM32 "));
      disp_st7789.print(F(Program_Name));
      disp_st7789.setFont(&FreeMono9pt7b);
      disp_st7789.setTextColor(ST77XX_CYAN);
      disp_st7789.setCursor(168, 11);
      disp_st7789.print(F(Program_Version));
      // display wait fix message and seconds count
      disp_st7789.setCursor(0, 36);
      disp_st7789.setTextColor(ST77XX_WHITE);
      disp_st7789.print(F("    Wait fix "));
      disp_st7789.print( (millis() - startGetFixmS) / 1000 );
      disp_st7789.print(F("s"));

      must_clear_disp_st7789 = true;      
    #endif // LCD_ST7789

    #ifdef GPSDO_TM1637
      tm1637.setSegments(low_oooo_s);
    #endif // TM1637    

    if (report_tab_delimited) {     // check what to print and where
      #ifdef GPSDO_BLUETOOTH        // print 0 message to either
        Serial2.println(F("0"));
      #else
        Serial.println(F("0"));
      #endif // BLUETOOTH
      report_line_no = 0;           // we restart linecount every time we lose GPS position fix (PPS)
    }
    else {
      #ifdef GPSDO_BLUETOOTH        // print no fix message to either
        Serial2.println();          // Bluetooth serial or USB serial
        Serial2.print(F("Waiting for GPS Fix "));
        Serial2.print( (millis() - startGetFixmS) / 1000 );
        Serial2.println(F("s"));
      #else
        Serial.println();
        Serial.print(F("Waiting for GPS Fix "));
        Serial.print( (millis() - startGetFixmS) / 1000 );
        Serial.println(F("s"));
      #endif // BLUETOOTH
    }
    
    // no fix or fix lost, we must flush the ring buffers,
    // so raise flush_ring_buffers_flag
    flush_ring_buffers_flag = true;
    #ifdef GPSDO_PICDIV
      must_arm_picDIV = true; // resync the picDIV whenever we lose GPS fix
    #endif // PICDIV
  }
  
} // end of loop()
