AndrewBCN/STM32-GPSDO/(commit log)

2021-05-11 This is version v0.02c. It's a major rewrite of many parts of version v0.01, but keeps the general structure of the Arduino sketch the same.
    The improvements are:
    - Code is easier to read and maintain, much improved comments and variables names.
    - The main loop allows for more time to read and decode NMEA sentences from the GPS.
    - Improved data and status reporting on USB serial, Bluetooth serial and OLED display.
    This is still work in progress and as such not fully functional, unlike v0.01.
2021-05-11 Picture of breadboard prototype
2021-05-12 Replaced picture with one with correct orientation. Sketch version bumped to v0.02d. DFLL control loop reimplemented, the control algorithm is now in a separate function for future improved and more 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
    [GPSDO.ino]
2021-05-12 Version v0.02e Modularized support for AHT10, BMP280, Bluetooth. OCXO frequency on OLED display. Compile time switch for verbose NMEA stream echoed to USB serial, Bluetooth (default is off)
2021-05-14 Version v0.02f. Improved frequency display on OLED. Added small separate sketch to set baud rate and name of HC-06 module. Fixed a couple of typos.
    [BT_HC06_config.ino, GPSDO.ino]
2021-05-15 Version v0.02g Reports uptime on USB serial, Bluetooth serial, OLED display. On OLED display uptime replaces HDOP. Uptime in days, hours, minutes, seconds.
    [GPSDO.ino]
2021-05-17 Added BOM.
2021-05-18 Version 0.02j Added code for INA219 sensor Added USB serial output sample .txt file
2021-05-18 Version 0.03a Major addition of a simple command parser using the SerialCommands library by Pedro Pereira https://github.com/ppedro74/Arduino-SerialCommands Improved algorithm for OCXO disciplining (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
2021-05-18 Version v0.03b Fixed a bug where the DAC output would not be adjusted Some code cleanup
    [GPSDO.ino]
2021-05-22 Version v0.03e First implementation of 64-bit counter in software. Testing 16-bit PWM to replace 12-bit DAC.
    [GPSDO.ino]
2021-05-24 Version v0.03g OCXO Vctl can now be generated using 16-bit PWM pin (plus RC filter) or MCP4725 12-bit I2C DAC. Function added to purge ring buffers. Sat fix loss purges ring buffers. Various small up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
    [GPSDO.ino]
2021-05-27 Version v0.03h Working 64-bit counter Working 1000s frequency average Work in progress 16-bit PWM to generate Vctl for the OCXO Implements up/down commands to control Vctl remotely
2021-05-28 Version v0.03i This is the final version in the 0.03 series. Implements 10,000 seconds ring buffer (that's 2h 46m 40s), tested and working. All known bugs have been fixed. 32-bit counter code was rem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
    [GPSDO.ino]
2021-06-01 Version v0.04a Increased HardwareSerial TX and RX buffer sizes from 64 to 256 characters. Auto-calibration routine is Work In Progress. 10,000 seconds ring buffer and average frequency: testing. U-bl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
2021-06-02 Added quick STM32 floating point test sketch in /extra
2021-06-06 Version v0.04e - All voltages read by MCU 12-bit ADC are now filtered by 10 samples (10s) moving average algorithm, using movingAvg library. - GPS serial port baud rate automatically switches from 96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
2021-06-06 Added GPS_Checker_With_Display_Mod.ino in /extra This is a small sketch to check that the STM32 MCU, the I2C OLED display and the u-Blox Neo-M8 GPS module are all working as intended.
2021-06-07 Added a document discussing the STM32 GPSDO precision in /doc
2021-06-08 Version v0.04f Implements tunnel mode command and operation. OLED display is now a configuration option Work started on calibration process, command is implemented, ongoing work on calibration algori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
    [GPSDO.ino]
2021-06-10 Version v0.04g Implements (finally) a simple linear interpolation calibration algorithm. It is not incredibly accurate but it has two advantages: 1. Simple to understand and code. 2. Requires 30 seco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
2021-06-10 Version v0.04h If PWM_DAC is defined, shows 16-bit PWM value on OLED display instead of DAC value.
2021-06-10 Added document comparing 16-bit PWM software DAC with 12-bit I2C DAC module
2021-06-12 Documentation Added docs/pictures folder with various pictures of the STM32 GPSDO, components, oscilloscope traces, etc
2021-12-30 Update GPSDO.ino
    - Added a second I2C instance to communicate with the INA219 on the third I2C interface (SDA3/SCL3)
    - Changed the INA219 initialisation to use Wire3 in accordance with the LapINA219 library's documentation
2022-02-04 Version v0.05a - Now requires STM32 Core version 2.2.0 or later. - Fixes small display bug after calibration. - Fixes MCP4725 not defined (default) compilation errors.
    [GPSDO.ino]
2022-02-04 Version v0.05b - Added 2kHz test signal generator on pin PB5. - Fixed bug in adjustVctlPWM() function which generated two adjustments when the OCXO frequency would come close to 10,000,000.000. Thank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
    [GPSDO.ino]
2022-02-04 Version v0.05c - Adds a command to set a PWM value between 1 and 65535.
2022-02-09 Version v0.05d - Manual merge of ST7735 SPI color LCD support by Badwater-Frank. - Preliminary work to support similar ST7789 SPI color LCD. - More conditional compilation for MCP4725 I2C 12-bit DAC 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
2022-02-10 Version v0.05e - Check PWM input value in SP command (must be between 1 and 65535)
2022-02-21 Version v0.05f - Added missing Bluetooth OCXO warmup messages - OCXO warmup now a separate function from calibration - Added countdown for calibration - Added selectable calibration countdowns (15s o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
    [GPSDO.ino]
2022-03-21 Version v0.05i "Stop the war in Ukraine" - ST7789 TFT LCD SPI display support. - BMP280 sensor on I2C bus support. - AHT20 support. - TM1637 4-digit LED clock display support. - MCP4725 I2C 12-bit DA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
    [GPSDO.ino, lcd_test_1a.ino]
2022-04-01 Version v0.05j "All it takes to stop the war in Ukraine is a phone call." - Added two documentation files in /docs. - Merged iannez pull request "Better use variables/constants". Thank you, excellent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
2022-04-11 Created schematics folder and added STM32 GPSDO schematic version 0.7 (PDF file).
2022-04-12 Updated STM32 GPSDO KiCad schematic to Revision 0.7.1 - Added frequency counter input selector circuit using 74HC157. - Added note about capacitor type for 1nF TIC capacitor.
2022-04-19 - ALPHA quality v0.06c in separate directory - control loop algorithm(s) now in separate file - New command LA n (where n=0 to 9) switches to Loop Algorithm n
2022-04-19 Fixed typo maxalgonumber = 9 (was 0).
    [GPSDO_V006c.ino]
2022-04-20 - small changes to BMP280 pressure and altitude measurements code. - added a comment explaining how to calibrate the BMP280 sensor using the PO and AO commands.
2022-04-22 Schematic version bumped to 0.7.2 - INA219 logic powered by 3.3V (VDD), not 5V (VCC). See note on page Extras 2.
2022-04-22 Alpha v0.06c: merged many ST7735 LCD display support code fixes from nealix
    [GPSDO_V006c.ino]
